OMARCITO007/plc-stm32/README.md

# plc-stm32
PLC básico basado en stm32 como controlador principal, con RS485, WIFI ESP32 y ETHERNET W5500

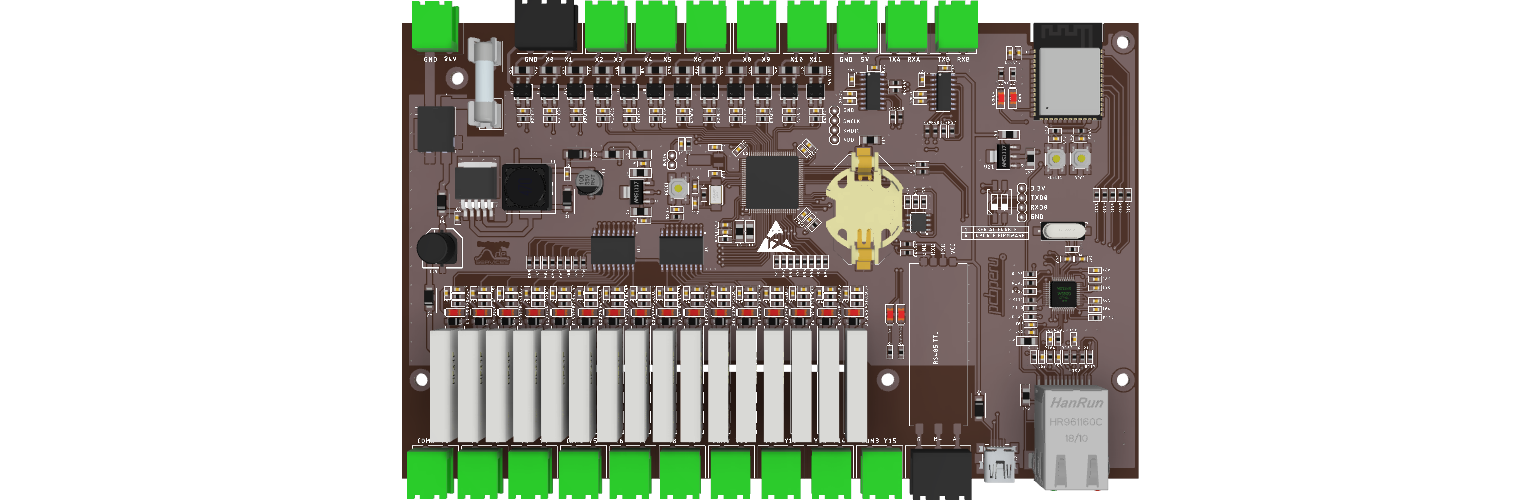
[picture p1: imagenes/PLC_YN_CPU v1.png]
Image text


## Microncontrolador
* ⚛️ STM32F407VGT6.
* 🍏 ESP32-WROOM-32U.

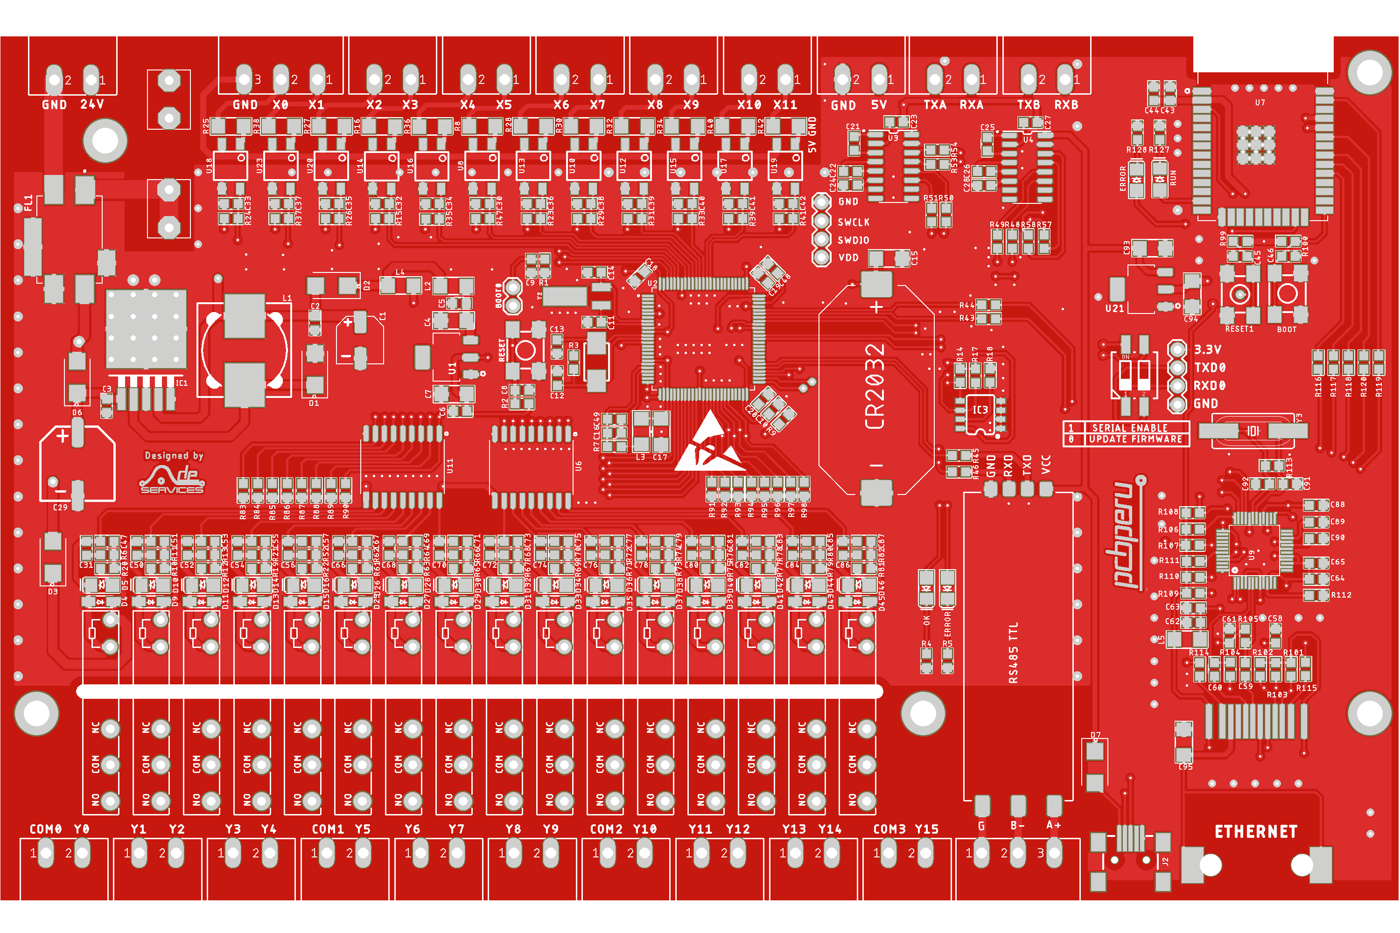
[picture p2: imagenes/PLC_YN_CPU.png]
Image text


## Voltaje de funcionamiento
* 🔌 24V.
* 🔌 Salida 5V.
## Caracteristicas
* 💙 x2 RS232.
* 💙 x1 RS485.
* 💙 x1 WIFI ESP32.
* 💙 x1 ETHERNET W5500.
* 💙 x1 EEPROM.
* 💙 x1 RTC.
* 💙 x1 USB para actualizar en modo BOOT y datos serial.
* ✔️ x12 entradas.
* ✔️ x16 salidas relé 2A.
