OMARCITO007/plc-stm32/imagenes/img.md

Imagen de la tarjeta pcb en 3D con los componentes
