OMARCITO007/plc-stm32/eagle-pcb/PLC_YN_CPU.brd

## EAGLE design eagle-pcb/PLC_YN_CPU.brd (2023-07-11)

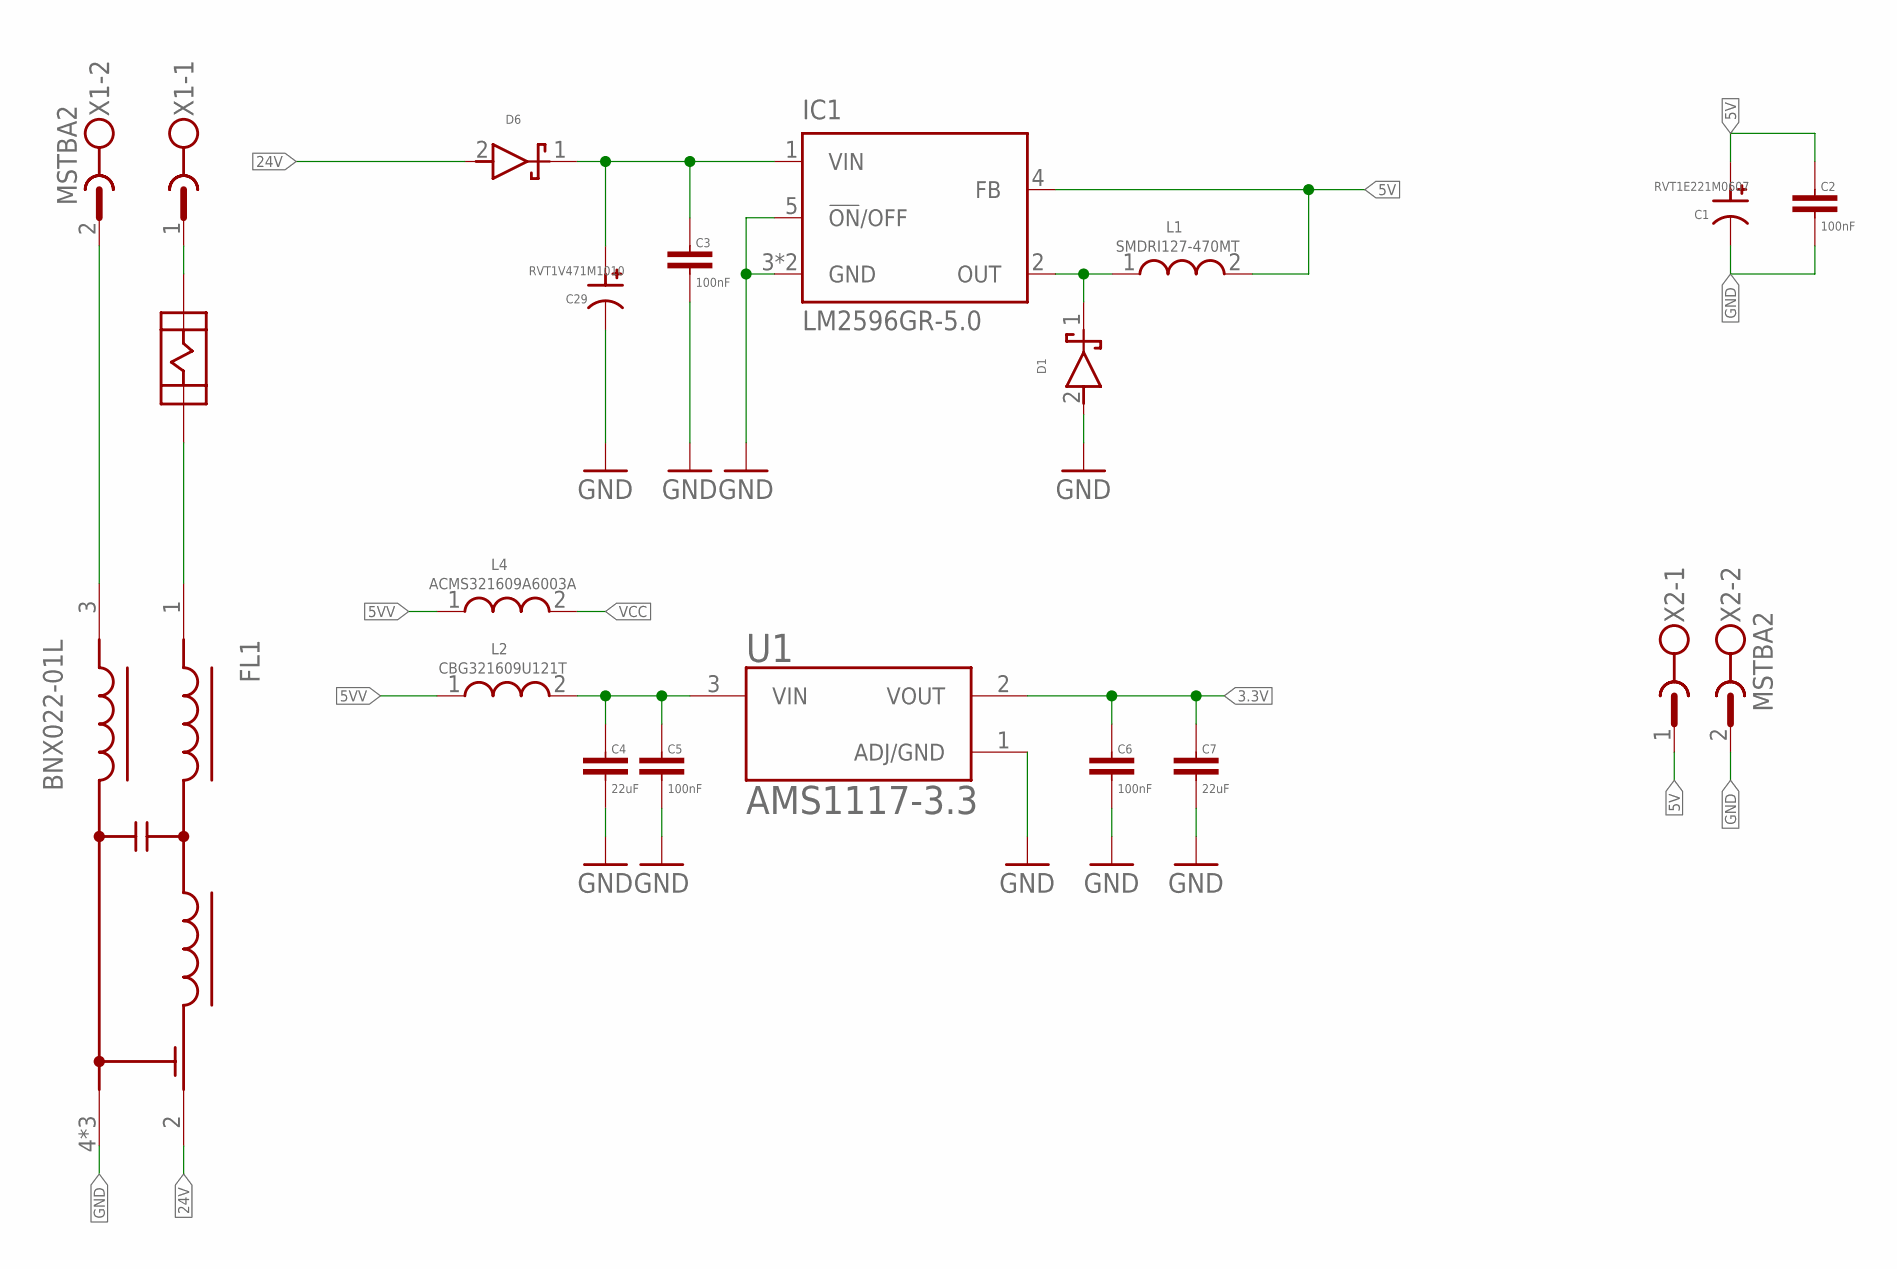
[picture p3: schematic PLC_YN_CPU.sch, sheet 1, ETAPA DE ALIMENTACIÓN]

Parts:
C1: RVT1E221M0607; CAP_100UF_6.3X7.7SMD
C2, C3, C5, C6: 100nF; C0603
C4, C7: 22uF; SMD_1206
C29: RVT1V471M1010; CAP_470UF_SMD_10X10.2
D1: SS36F; B360
D6: SS56; B360
F2: 3A; PORTAFUSIBLE
FL1: BNX022-01L; FIL_BNX022-01L
IC1: LM2596GR-5.0; TO263-5
L1: SMDRI127-470MT; IND
L2: CBG321609U121T; SMD_1206
L4: ACMS321609A6003A; SMD_1206
U1: AMS1117-3.3; SOT229P700X180-4N
X1, X2: MSTBA2

Connections:
3.3V: C6.1, C7.1, U1.2 (VOUT); also elsewhere on the board
5V: C1.P (1), C2.1, IC1.4 (FB), L1.2, X2.1; also elsewhere on the board
5VV: L2.1, L4.1; also elsewhere on the board
24V: D6.2, FL1.2 (CB); also elsewhere on the board
GND: C1.N (2), C2.2, C3.2, C4.2, C5.2, C6.2, C7.2, C29.N (2), D1.2, FL1.4 (CG), FL1.5 (CG), FL1.6 (CG), IC1.3 (GND), IC1.5 (!ON!/OFF), IC1.6 (GND), U1.1 (ADJ/GND), X2.2; also elsewhere on the board
unnamed: C4.1, C5.1, L2.2, U1.3 (VIN)
unnamed: C3.1, C29.P (1), D6.1, IC1.1 (VIN)
unnamed: D1.1, IC1.2 (OUT), L1.1
unnamed: F2.P$2, F2.P$4, X1.1
unnamed: FL1.3 (PSG), X1.2
unnamed: F2.P$1, F2.P$3, FL1.1 (B)
VCC: L4.2; also elsewhere on the board

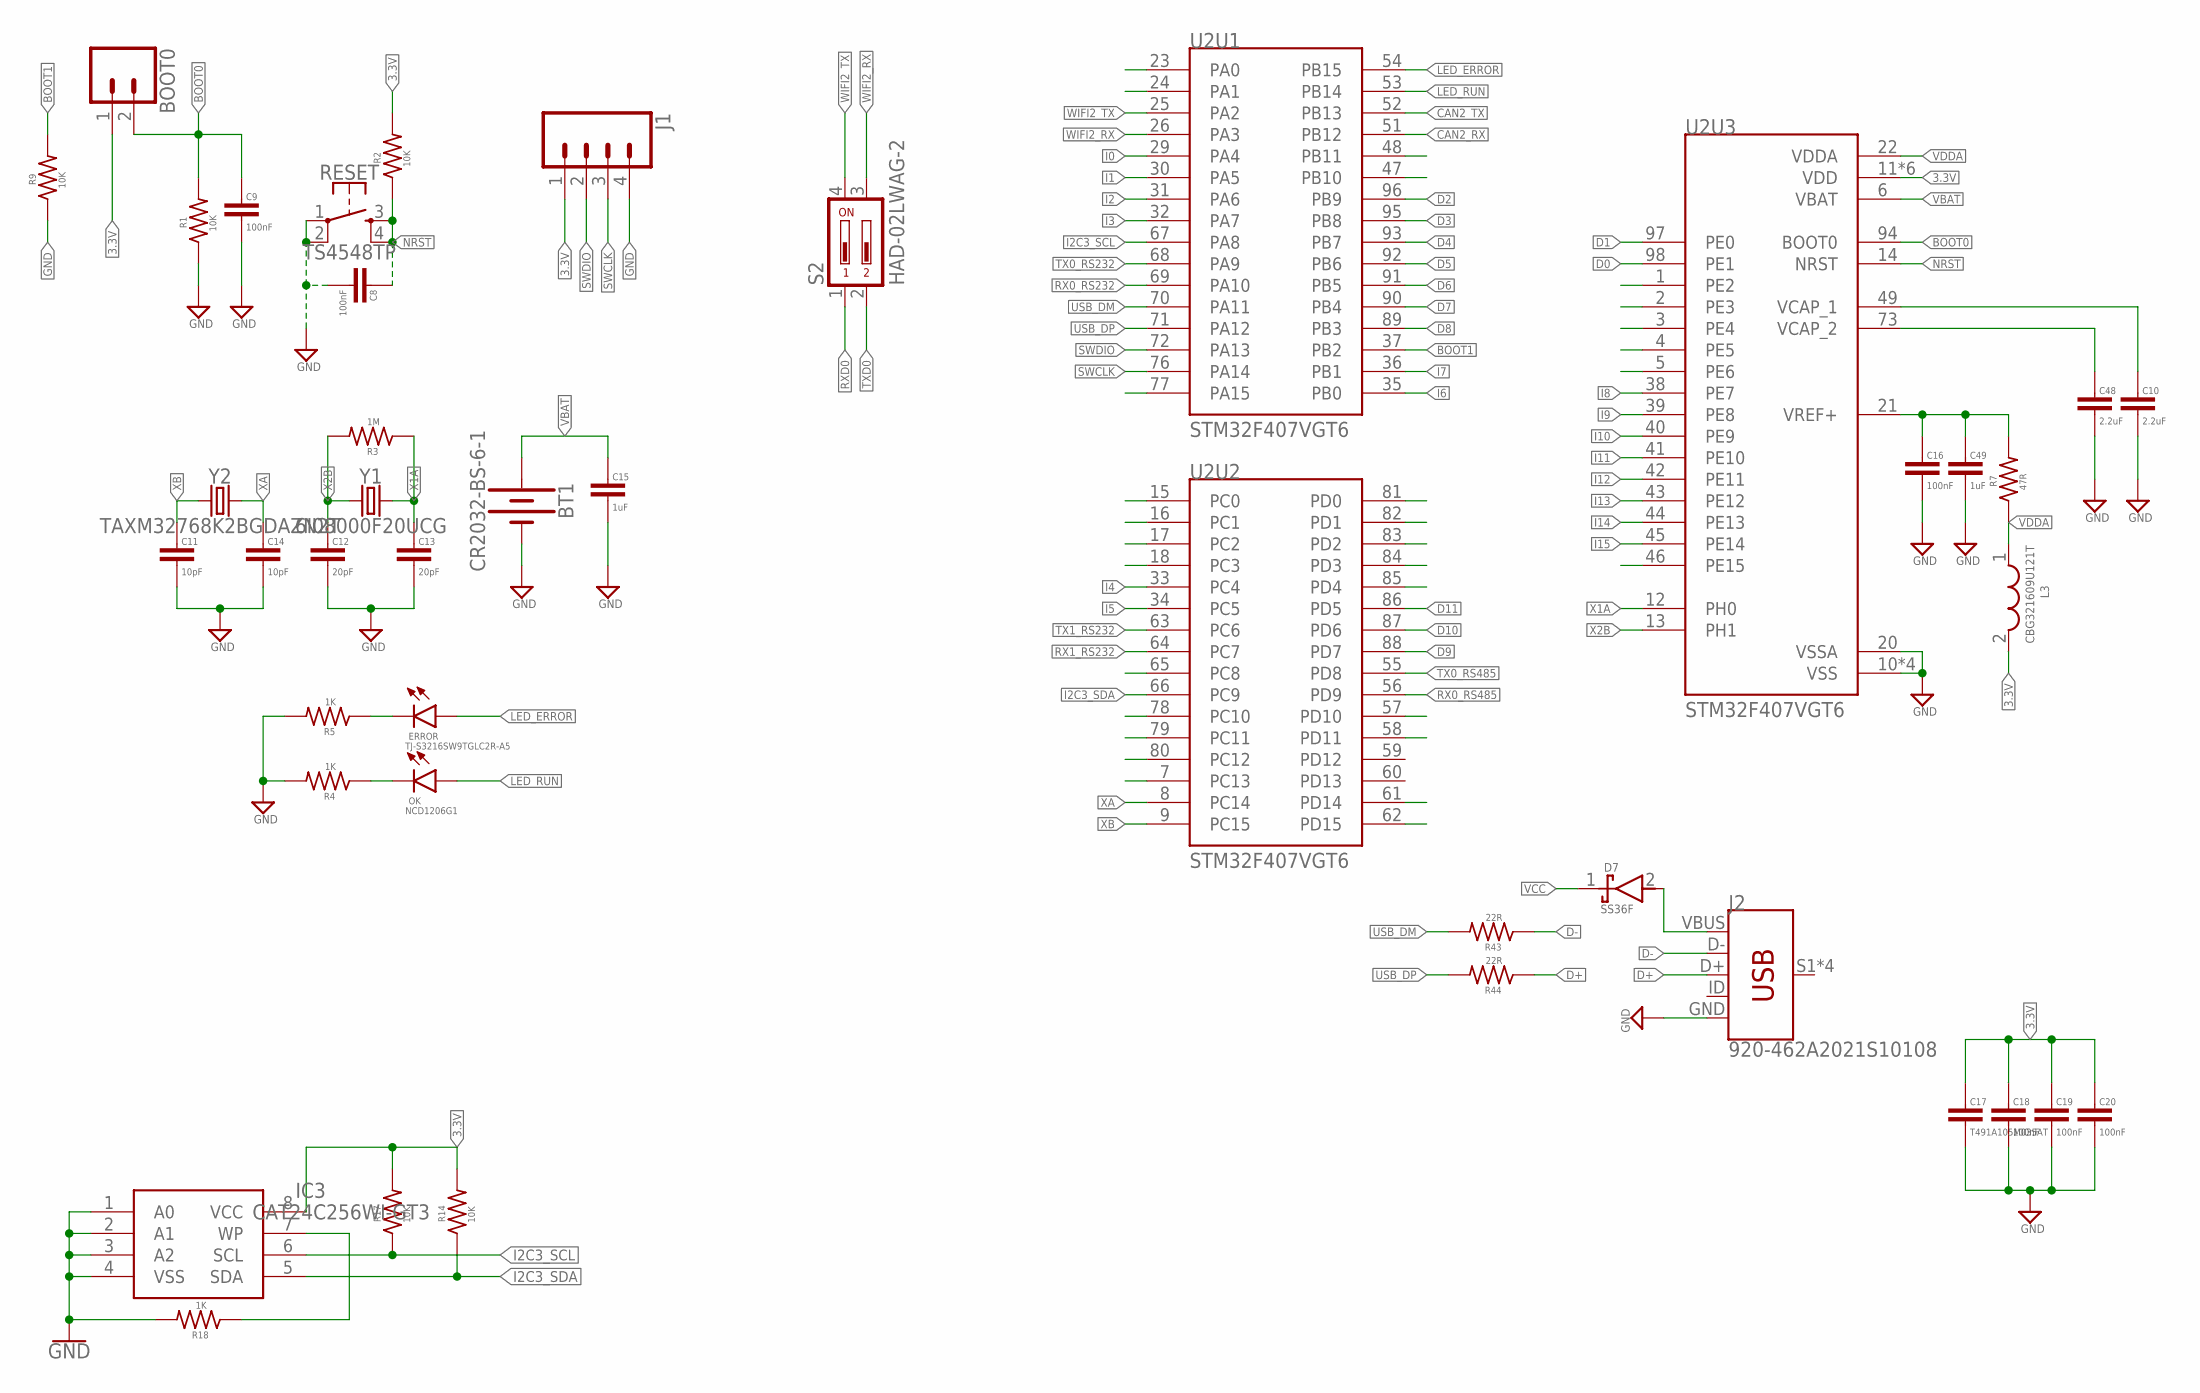
[picture p4: schematic PLC_YN_CPU.sch, sheet 2, MCU STM32F446]

Parts:
BOOT0: CONN_02; 1X02
BT1: CR2032-BS-6-1; BAT_CR2032_SMD
C8, C9, C16, C18, C19, C20: 100nF; C0603
C10, C48: 2.2uF; C0603
C11, C14: 10pF; C0603
C12, C13: 20pF; C0603
C15: 1uF; SMD_1206
C17: T491A105M035AT; SMD_1206
C49: 1uF; C0603
D7: SS36F; B360
ERROR: TJ-S3216SW9TGLC2R-A5; L1206
IC3: CAT24C256WI-GT3; SO08
J1: CONN_04; 1X04
J2: 920-462A2021S10108; USB-MINIB
L3: CBG321609U121T; SMD_1206
OK: NCD1206G1; L1206
R1, R2, R9, R14, R17: 10K; R0603
R3: 1M; R0603
R4, R5, R18: 1K; R0603
R7: 47R; R0603
R43, R44: 22R; R0603
RESET: TS4548TP; SWITCH
S2: HAD-02LWAG-2; CTS-219-02
U2: STM32F407VGT6; QFP50P1600X1600X160-100N
Y1: 6I08000F20UCG; CRYSTAL-SMD-5X3.2-2PAD
Y2: TAXM32768K2BGDAZN2T; CRYSTAL-SMD-2X6-CYL

Connections:
3.3V: BOOT0.1, C17.1, C18.1, C19.1, C20.1, IC3.8 (VCC), J1.1, L3.2, R2.2, R14.2, R17.2, U2.11 (VDD), U2.19 (VDD), U2.28 (VDD), U2.50 (VDD), U2.75 (VDD), U2.100 (VDD); also elsewhere on the board
BOOT0: BOOT0.2, C9.1, R1.2, U2.94 (BOOT0)
BOOT1: R9.2, U2.37 (PB2)
CAN2_RX: U2.51 (PB12)
CAN2_TX: U2.52 (PB13)
D0: U2.98 (PE1); also elsewhere on the board
D1: U2.97 (PE0); also elsewhere on the board
D2: U2.96 (PB9); also elsewhere on the board
D3: U2.95 (PB8); also elsewhere on the board
D4: U2.93 (PB7); also elsewhere on the board
D5: U2.92 (PB6); also elsewhere on the board
D6: U2.91 (PB5); also elsewhere on the board
D7: U2.90 (PB4); also elsewhere on the board
D8: U2.89 (PB3); also elsewhere on the board
D9: U2.88 (PD7); also elsewhere on the board
D10: U2.87 (PD6); also elsewhere on the board
D11: U2.86 (PD5); also elsewhere on the board
D+: J2.D+, R44.1
D-: J2.D-, R43.1
GND: BT1.N (-), C8.2, C9.2, C10.2, C11.2, C12.2, C13.2, C14.2, C15.2, C16.2, C17.2, C18.2, C19.2, C20.2, C48.2, C49.2, IC3.1 (A0), IC3.2 (A1), IC3.3 (A2), IC3.4 (VSS), J1.4, J2.GND, R1.1, R4.2, R5.2, R9.1, R18.2, RESET.1, RESET.2, U2.10 (VSS), U2.20 (VSSA), U2.27 (VSS), U2.74 (VSS), U2.99 (VSS); also elsewhere on the board
I0: U2.29 (PA4); also elsewhere on the board
I1: U2.30 (PA5); also elsewhere on the board
I2: U2.31 (PA6); also elsewhere on the board
I2C3_SCL: IC3.6 (SCL), R17.1, U2.67 (PA8)
I2C3_SDA: IC3.5 (SDA), R14.1, U2.66 (PC9)
I3: U2.32 (PA7); also elsewhere on the board
I4: U2.33 (PC4); also elsewhere on the board
I5: U2.34 (PC5); also elsewhere on the board
I6: U2.35 (PB0); also elsewhere on the board
I7: U2.36 (PB1); also elsewhere on the board
I8: U2.38 (PE7); also elsewhere on the board
I9: U2.39 (PE8); also elsewhere on the board
I10: U2.40 (PE9); also elsewhere on the board
I11: U2.41 (PE10); also elsewhere on the board
I12: U2.42 (PE11); also elsewhere on the board
I13: U2.43 (PE12); also elsewhere on the board
I14: U2.44 (PE13); also elsewhere on the board
I15: U2.45 (PE14); also elsewhere on the board
LED_ERROR: ERROR.A, U2.54 (PB15)
LED_RUN: OK.A, U2.53 (PB14)
unnamed: C10.1, U2.49 (VCAP_1)
unnamed: C48.1, U2.73 (VCAP_2)
unnamed: C16.1, C49.1, R7.2, U2.21 (VREF+)
unnamed: D7.2, J2.VBUS
unnamed: IC3.7 (WP), R18.1
unnamed: ERROR.C, R5.1
unnamed: OK.C, R4.1
NRST: C8.1, R2.1, RESET.3, RESET.4, U2.14 (NRST)
RX0_RS232: U2.69 (PA10); also elsewhere on the board
RX0_RS485: U2.56 (PD9); also elsewhere on the board
RX1_RS232: U2.64 (PC7); also elsewhere on the board
RXD0: S2.1; also elsewhere on the board
SWCLK: J1.3, U2.76 (PA14)
SWDIO: J1.2, U2.72 (PA13)
TX0_RS232: U2.68 (PA9); also elsewhere on the board
TX0_RS485: U2.55 (PD8); also elsewhere on the board
TX1_RS232: U2.63 (PC6); also elsewhere on the board
TXD0: S2.2; also elsewhere on the board
USB_DM: R43.2, U2.70 (PA11)
USB_DP: R44.2, U2.71 (PA12)
VBAT: BT1.P (+), C15.1, U2.6 (VBAT)
VCC: D7.1; also elsewhere on the board
VDDA: L3.1, R7.1, U2.22 (VDDA)
WIFI2_RX: S2.3, U2.26 (PA3)
WIFI2_TX: S2.4, U2.25 (PA2)
X1A: C13.1, R3.1, U2.12 (PH0), Y1.P$2 (2)
X2B: C12.1, R3.2, U2.13 (PH1), Y1.P$1 (1)
XA: C14.1, U2.8 (PC14), Y2.X2 (2)
XB: C11.1, U2.9 (PC15), Y2.X1 (1)

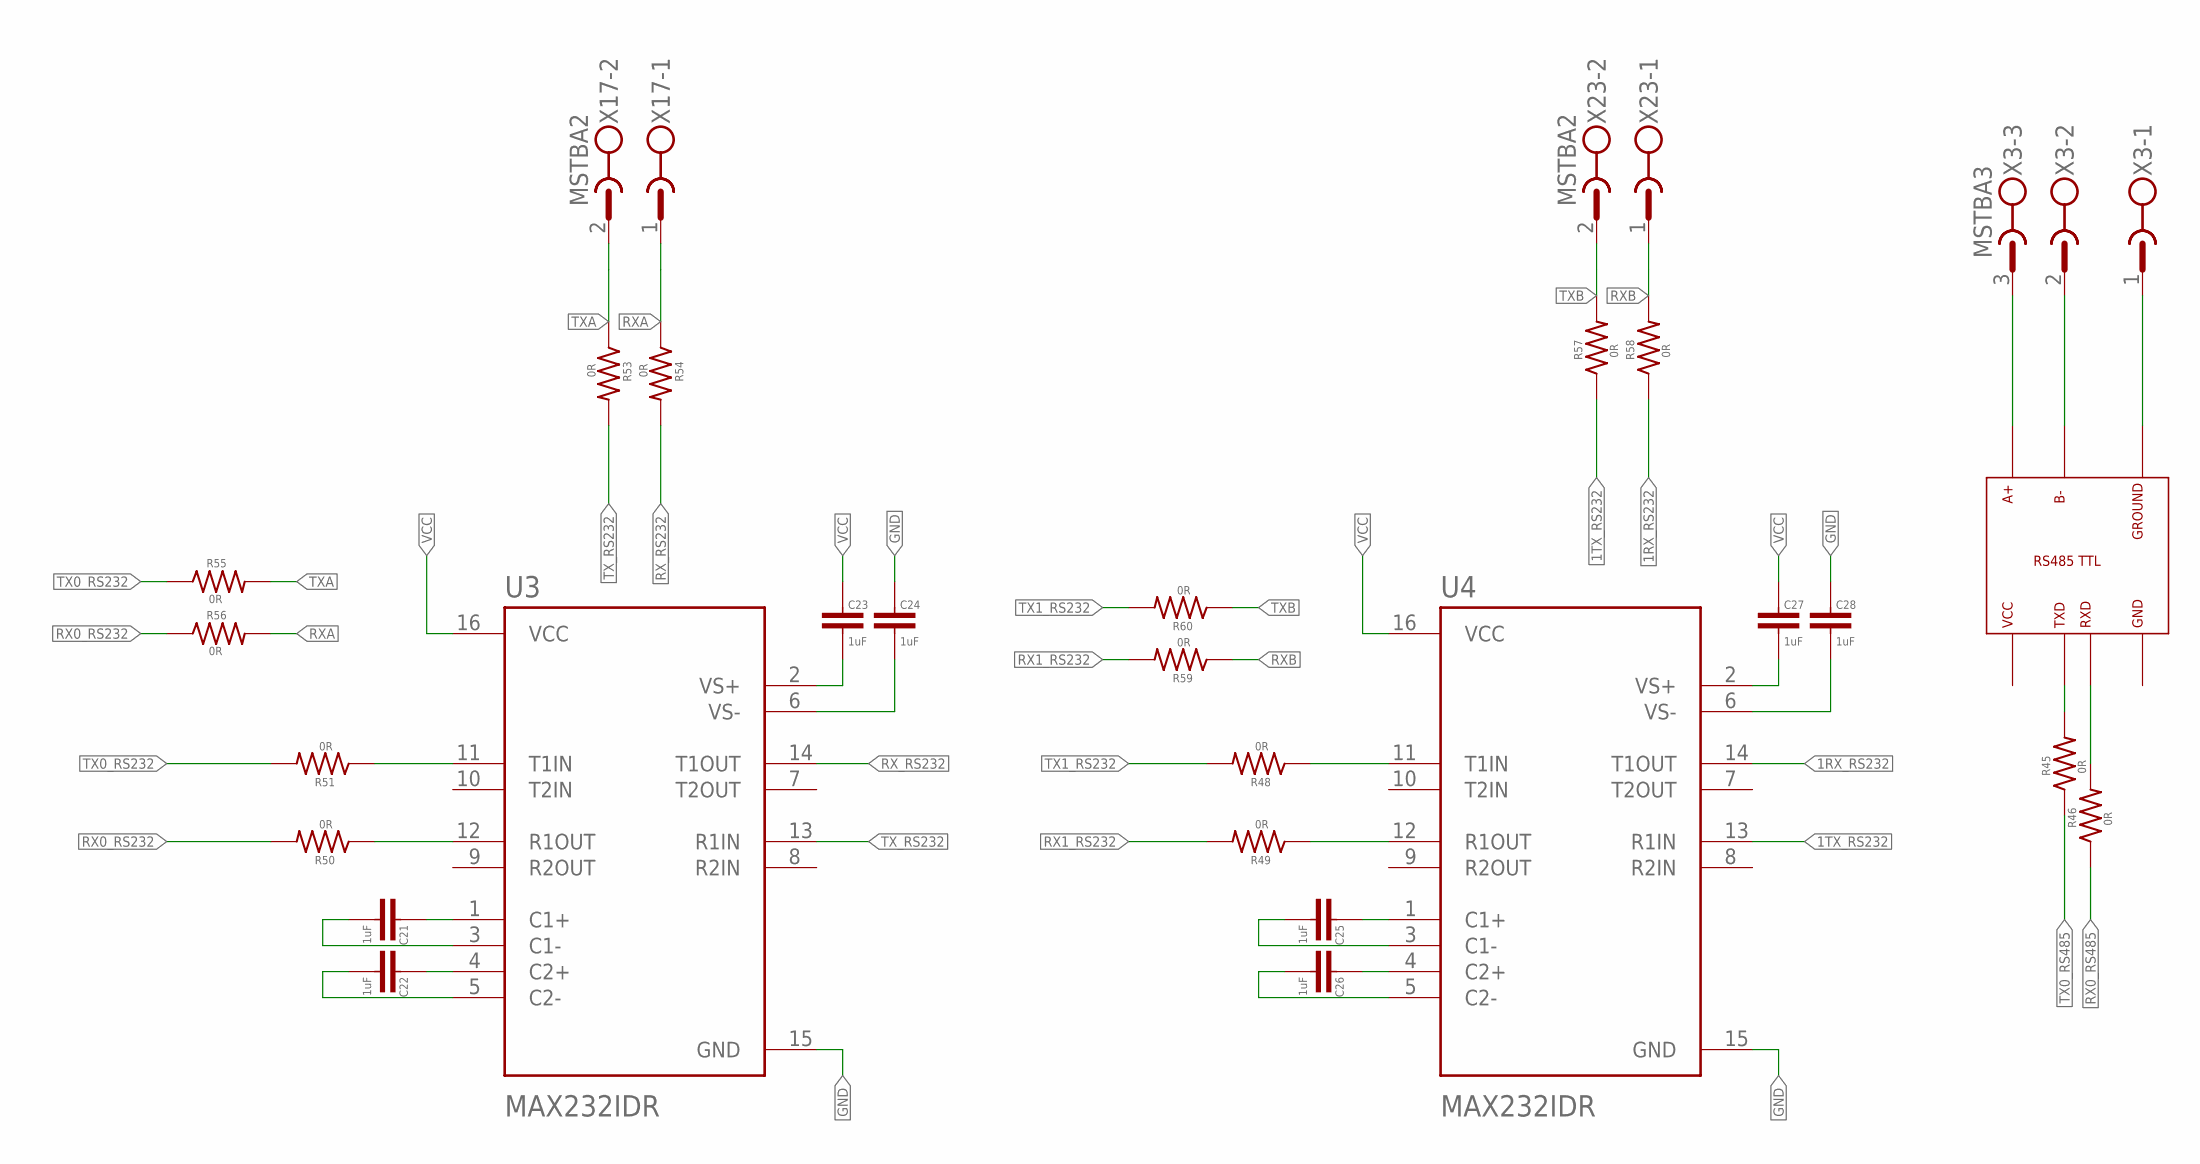
[picture p5: schematic PLC_YN_CPU.sch, sheet 3, COMUNICACION]

Parts:
C21, C22, C23, C24, C25, C26, C27, C28: 1uF; C0603
R45, R46, R48, R49, R50, R51, R53, R54, R55, R56, R57, R58, R59, R60: 0R; R0603
U3, U4: MAX232IDR; SOIC127P600X175-16N
U5: RS485; RS485TTL
X3: MSTBA3
X17, X23: MSTBA2

Connections:
1RX_RS232: R58.1, U4.14 (T1OUT)
1TX_RS232: R57.1, U4.13 (R1IN)
GND: C24.1, C28.1, U3.15 (GND), U4.15 (GND), U5.GND; also elsewhere on the board
unnamed: U5.A+, X3.3
unnamed: R45.2, U5.TXD
unnamed: U5.B-, X3.2
unnamed: U5.GROUND, X3.1
unnamed: C21.1, U3.1 (C1+)
unnamed: C21.2, U3.3 (C1-)
unnamed: C22.1, U3.4 (C2+)
unnamed: C22.2, U3.5 (C2-)
unnamed: C25.1, U4.1 (C1+)
unnamed: C23.2, U3.2 (VS+)
unnamed: C24.2, U3.6 (VS-)
unnamed: C25.2, U4.3 (C1-)
unnamed: C26.1, U4.4 (C2+)
unnamed: C26.2, U4.5 (C2-)
unnamed: C27.2, U4.2 (VS+)
unnamed: C28.2, U4.6 (VS-)
unnamed: R46.2, U5.RXD
unnamed: R48.1, U4.11 (T1IN)
unnamed: R49.1, U4.12 (R1OUT)
unnamed: R50.1, U3.12 (R1OUT)
unnamed: R51.1, U3.11 (T1IN)
RX0_RS232: R50.2, R56.1; also elsewhere on the board
RX0_RS485: R46.1; also elsewhere on the board
RX1_RS232: R49.2, R59.2; also elsewhere on the board
RXA: R54.1, R56.2, X17.1
RXB: R58.2, R59.1, X23.1
RX_RS232: R54.2, U3.14 (T1OUT)
TX0_RS232: R51.2, R55.1; also elsewhere on the board
TX0_RS485: R45.1; also elsewhere on the board
TX1_RS232: R48.2, R60.2; also elsewhere on the board
TXA: R53.1, R55.2, X17.2
TXB: R57.2, R60.1, X23.2
TX_RS232: R53.2, U3.13 (R1IN)
VCC: C23.1, C27.1, U3.16 (VCC), U4.16 (VCC), U5.VCC; also elsewhere on the board

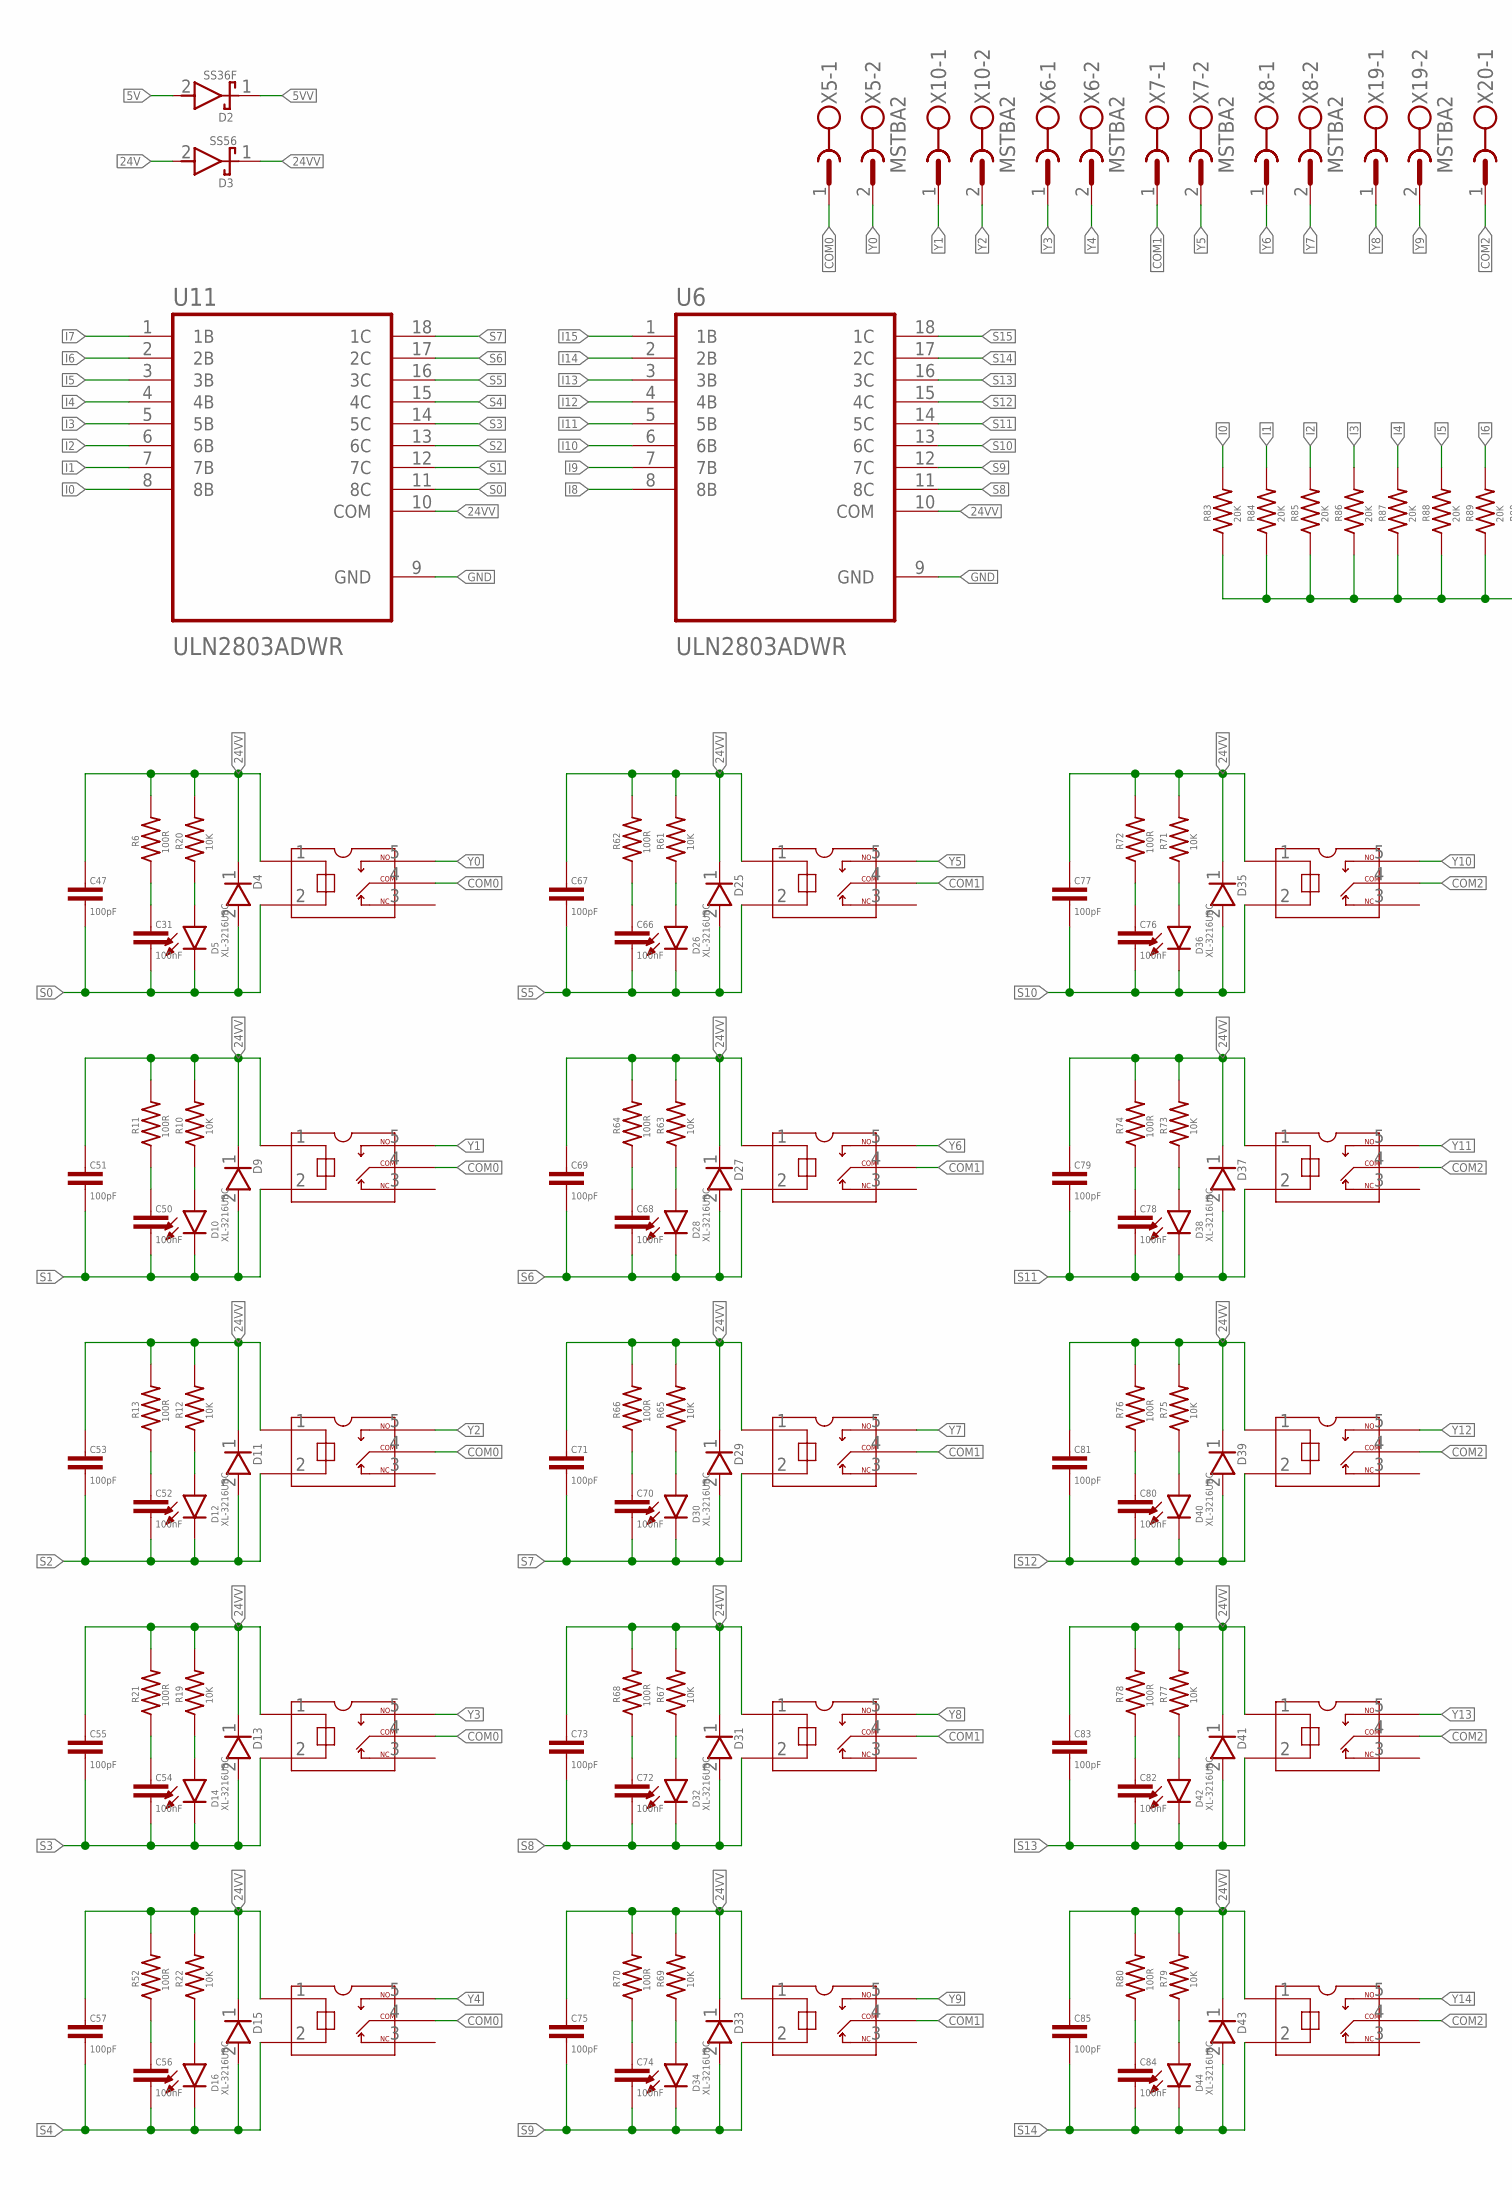
[picture p6: schematic PLC_YN_CPU.sch, sheet 4, OUTPUT, part in row 1, column 1]

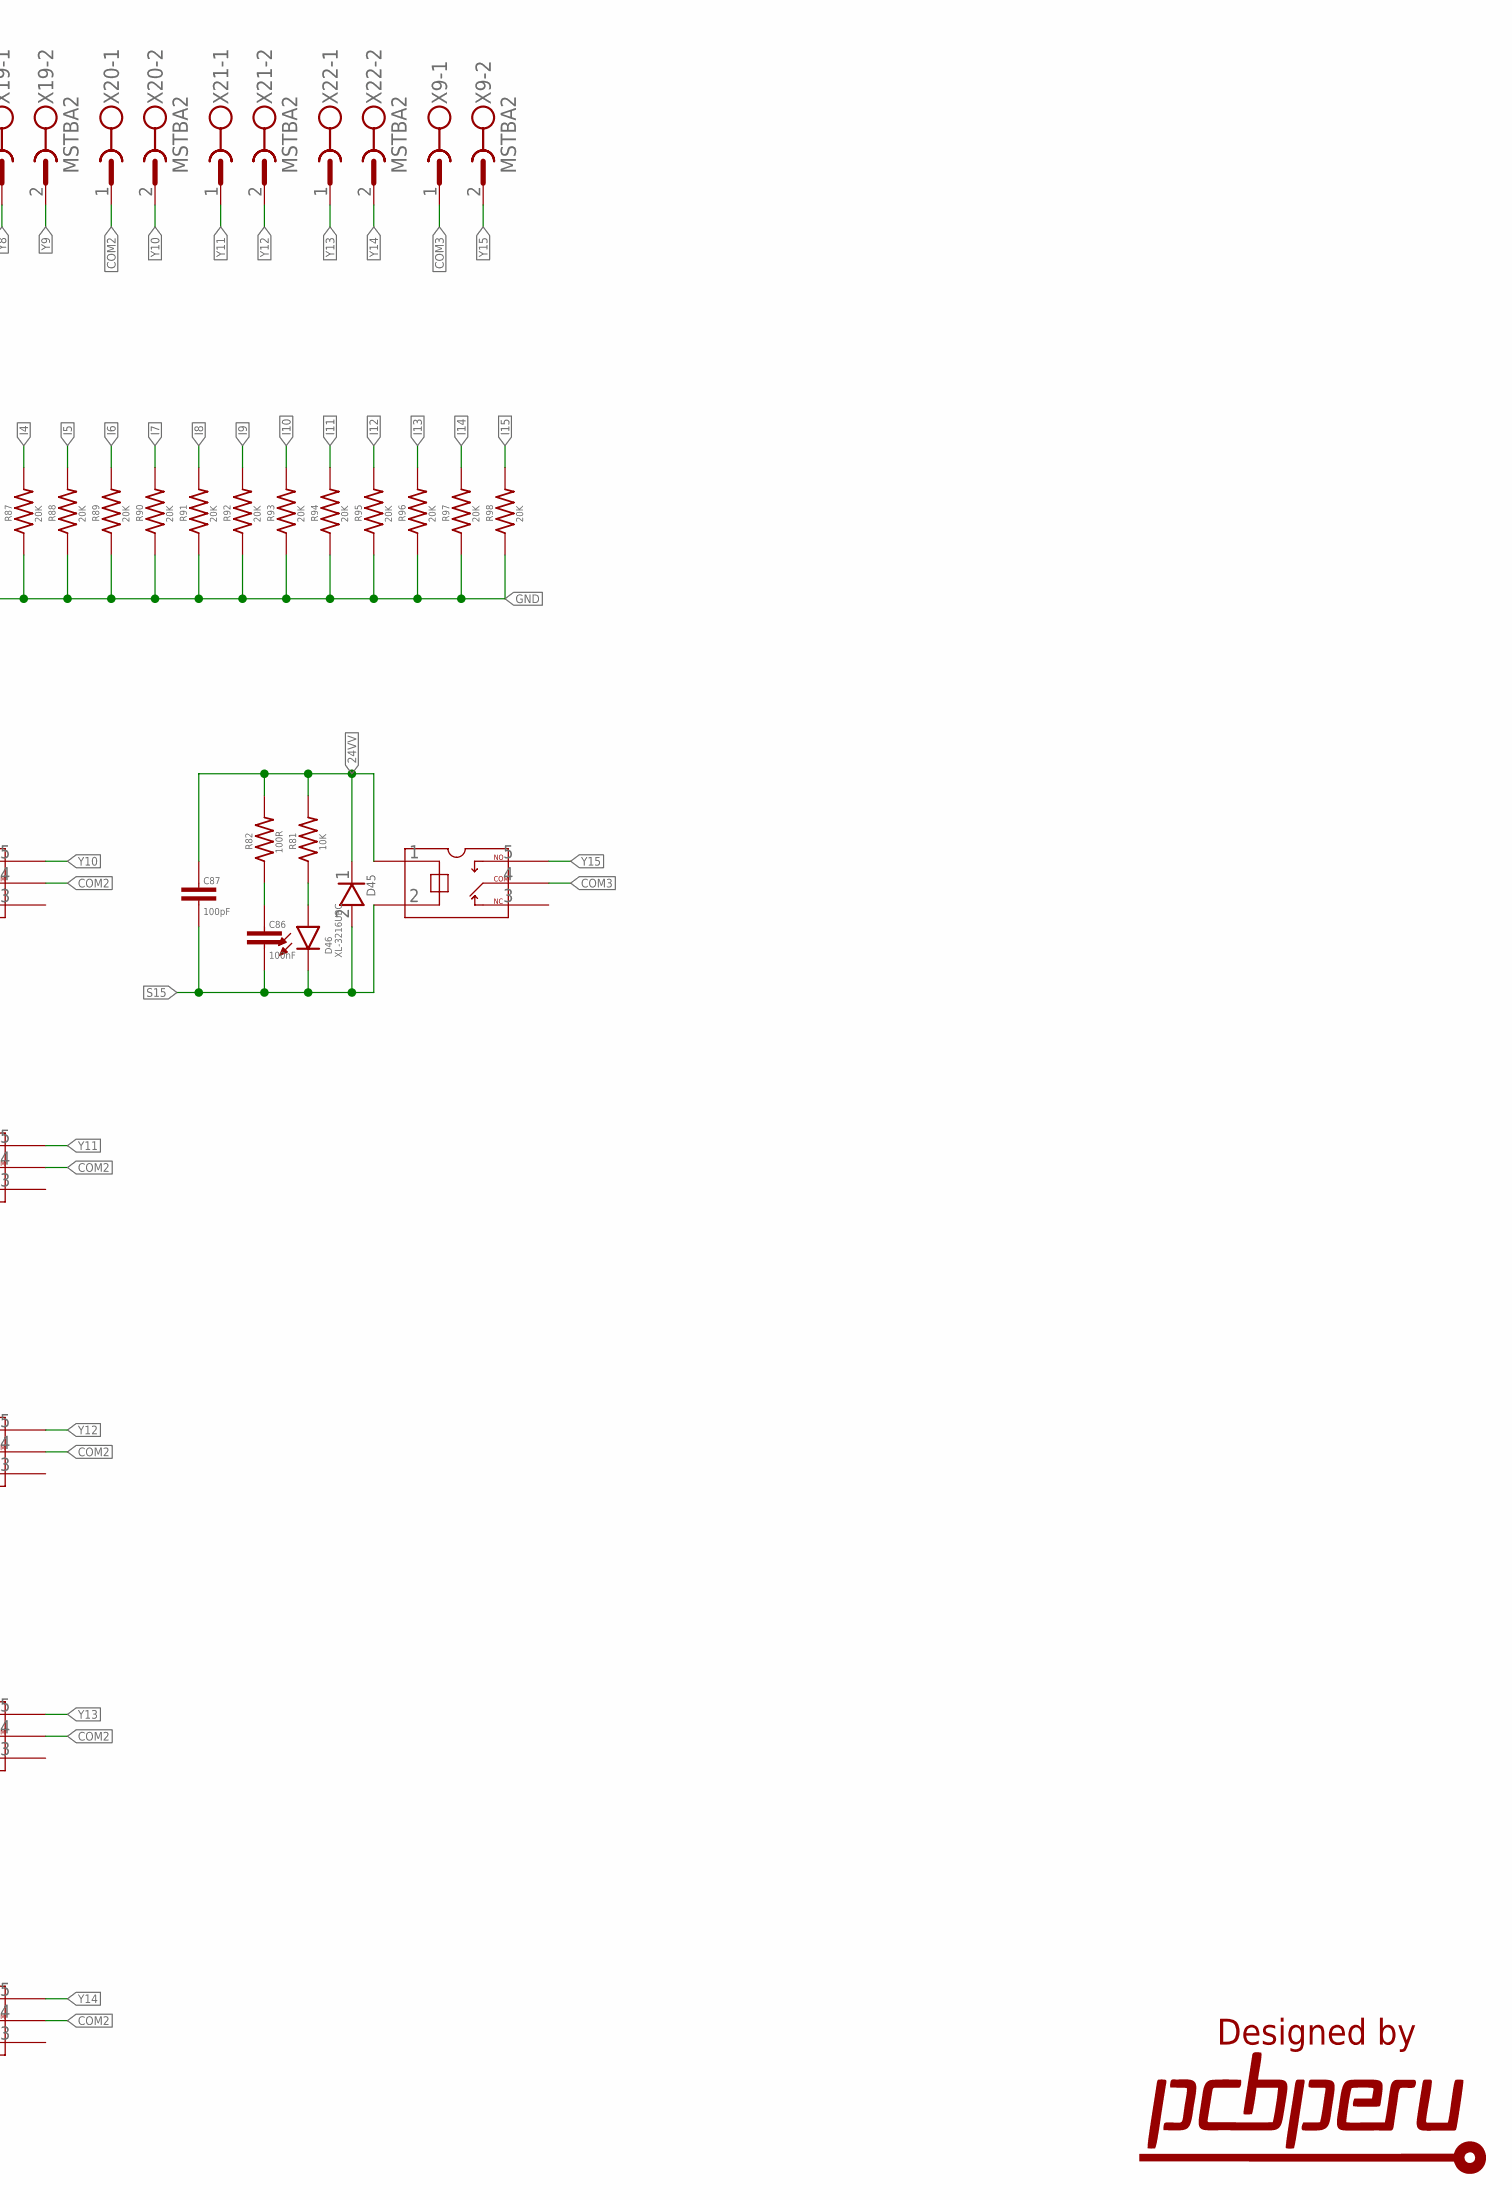
[picture p7: schematic PLC_YN_CPU.sch, sheet 4, OUTPUT, part in row 1, column 2]

Parts:
C31, C50, C52, C54, C56, C66, C68, C70, C72, C74, C76, C78, C80, C82, C84, C86: 100nF; C0603
C47, C51, C53, C55, C57, C67, C69, C71, C73, C75, C77, C79, C81, C83, C85, C87: 100pF; C0603
D2: SS36F; B360
D3: SS56; B360
D4, D9, D11, D13, D15, D25, D27, D29, D31, D33, D35, D37, D39, D41, D43, D45: 1N4148W-13-F; SOD3716X145N
D5, D10, D12, D14, D16, D26, D28, D30, D32, D34, D36, D38, D40, D42, D44, D46: XL-3216UBC; L1206
R6, R11, R13, R21, R52, R62, R64, R66, R68, R70, R72, R74, R76, R78, R80, R82: 100R; R0603
R10, R12, R19, R20, R22, R61, R63, R65, R67, R69, R71, R73, R75, R77, R79, R81: 10K; R0603
R83, R84, R85, R86, R87, R88, R89, R90, R91, R92, R93, R94, R95, R96, R97, R98: 20K; R0603
RL1, RL3, RL4, RL5, RL6, RL11, RL12, RL13, RL14, RL15, RL16, RL17, RL18, RL19, RL20, RL21: HF41F
U6, U11: ULN2803ADWR; SOIC127P1030X265-18N
X5, X6, X7, X8, X9, X10, X19, X20, X21, X22: MSTBA2

Connections:
5V: D2.2; also elsewhere on the board
5VV: D2.1; also elsewhere on the board
24V: D3.2; also elsewhere on the board
24VV: C47.1, C51.1, C53.1, C55.1, C57.1, C67.1, C69.1, C71.1, C73.1, C75.1, C77.1, C79.1, C81.1, C83.1, C85.1, C87.1, D3.1, D4.1 (K), D9.1 (K), D11.1 (K), D13.1 (K), D15.1 (K), D25.1 (K), D27.1 (K), D29.1 (K), D31.1 (K), D33.1 (K), D35.1 (K), D37.1 (K), D39.1 (K), D41.1 (K), D43.1 (K), D45.1 (K), R6.2, R10.2, R11.2, R12.2, R13.2, R19.2, R20.2, R21.2, R22.2, R52.2, R61.2, R62.2, R63.2, R64.2, R65.2, R66.2, R67.2, R68.2, R69.2, R70.2, R71.2, R72.2, R73.2, R74.2, R75.2, R76.2, R77.2, R78.2, R79.2, R80.2, R81.2, R82.2, RL1.1, RL3.1, RL4.1, RL5.1, RL6.1, RL11.1, RL12.1, RL13.1, RL14.1, RL15.1, RL16.1, RL17.1, RL18.1, RL19.1, RL20.1, RL21.1, U6.10 (COM), U11.10 (COM)
COM0: RL1.4, RL3.4, RL4.4, RL5.4, RL6.4, X5.1
COM1: RL11.4, RL12.4, RL13.4, RL14.4, RL15.4, X7.1
COM2: RL16.4, RL17.4, RL18.4, RL19.4, RL20.4, X20.1
COM3: RL21.4, X9.1
GND: R83.1, R84.1, R85.1, R86.1, R87.1, R88.1, R89.1, R90.1, R91.1, R92.1, R93.1, R94.1, R95.1, R96.1, R97.1, R98.1, U6.9 (GND), U11.9 (GND); also elsewhere on the board
I0: R83.2, U11.8 (8B); also elsewhere on the board
I1: R84.2, U11.7 (7B); also elsewhere on the board
I2: R85.2, U11.6 (6B); also elsewhere on the board
I3: R86.2, U11.5 (5B); also elsewhere on the board
I4: R87.2, U11.4 (4B); also elsewhere on the board
I5: R88.2, U11.3 (3B); also elsewhere on the board
I6: R89.2, U11.2 (2B); also elsewhere on the board
I7: R90.2, U11.1 (1B); also elsewhere on the board
I8: R91.2, U6.8 (8B); also elsewhere on the board
I9: R92.2, U6.7 (7B); also elsewhere on the board
I10: R93.2, U6.6 (6B); also elsewhere on the board
I11: R94.2, U6.5 (5B); also elsewhere on the board
I12: R95.2, U6.4 (4B); also elsewhere on the board
I13: R96.2, U6.3 (3B); also elsewhere on the board
I14: R97.2, U6.2 (2B); also elsewhere on the board
I15: R98.2, U6.1 (1B); also elsewhere on the board
unnamed: C31.1, R6.1
unnamed: D10.A, R10.1
unnamed: D5.A, R20.1
unnamed: C50.1, R11.1
unnamed: D12.A, R12.1
unnamed: C52.1, R13.1
unnamed: D14.A, R19.1
unnamed: C54.1, R21.1
unnamed: D16.A, R22.1
unnamed: C56.1, R52.1
unnamed: D26.A, R61.1
unnamed: C66.1, R62.1
unnamed: D28.A, R63.1
unnamed: C68.1, R64.1
unnamed: D30.A, R65.1
unnamed: C70.1, R66.1
unnamed: D32.A, R67.1
unnamed: C72.1, R68.1
unnamed: D34.A, R69.1
unnamed: C74.1, R70.1
unnamed: D36.A, R71.1
unnamed: C76.1, R72.1
unnamed: D38.A, R73.1
unnamed: C78.1, R74.1
unnamed: D40.A, R75.1
unnamed: C80.1, R76.1
unnamed: D42.A, R77.1
unnamed: C82.1, R78.1
unnamed: D44.A, R79.1
unnamed: C84.1, R80.1
unnamed: D46.A, R81.1
unnamed: C86.1, R82.1
S0: C31.2, C47.2, D4.2 (A), D5.C, RL1.2, U11.11 (8C)
S1: C50.2, C51.2, D9.2 (A), D10.C, RL3.2, U11.12 (7C)
S2: C52.2, C53.2, D11.2 (A), D12.C, RL4.2, U11.13 (6C)
S3: C54.2, C55.2, D13.2 (A), D14.C, RL5.2, U11.14 (5C)
S4: C56.2, C57.2, D15.2 (A), D16.C, RL6.2, U11.15 (4C)
S5: C66.2, C67.2, D25.2 (A), D26.C, RL11.2, U11.16 (3C)
S6: C68.2, C69.2, D27.2 (A), D28.C, RL12.2, U11.17 (2C)
S7: C70.2, C71.2, D29.2 (A), D30.C, RL13.2, U11.18 (1C)
S8: C72.2, C73.2, D31.2 (A), D32.C, RL14.2, U6.11 (8C)
S9: C74.2, C75.2, D33.2 (A), D34.C, RL15.2, U6.12 (7C)
S10: C76.2, C77.2, D35.2 (A), D36.C, RL16.2, U6.13 (6C)
S11: C78.2, C79.2, D37.2 (A), D38.C, RL17.2, U6.14 (5C)
S12: C80.2, C81.2, D39.2 (A), D40.C, RL18.2, U6.15 (4C)
S13: C82.2, C83.2, D41.2 (A), D42.C, RL19.2, U6.16 (3C)
S14: C84.2, C85.2, D43.2 (A), D44.C, RL20.2, U6.17 (2C)
S15: C86.2, C87.2, D45.2 (A), D46.C, RL21.2, U6.18 (1C)
Y0: RL1.5, X5.2
Y1: RL3.5, X10.1
Y2: RL4.5, X10.2
Y3: RL5.5, X6.1
Y4: RL6.5, X6.2
Y5: RL11.5, X7.2
Y6: RL12.5, X8.1
Y7: RL13.5, X8.2
Y8: RL14.5, X19.1
Y9: RL15.5, X19.2
Y10: RL16.5, X20.2
Y11: RL17.5, X21.1
Y12: RL18.5, X21.2
Y13: RL19.5, X22.1
Y14: RL20.5, X22.2
Y15: RL21.5, X9.2
