OMARCITO007/plc-stm32/eagle-pcb/PLC_YN_CPU.brd

## EAGLE design eagle-pcb/PLC_YN_CPU.brd (continued)

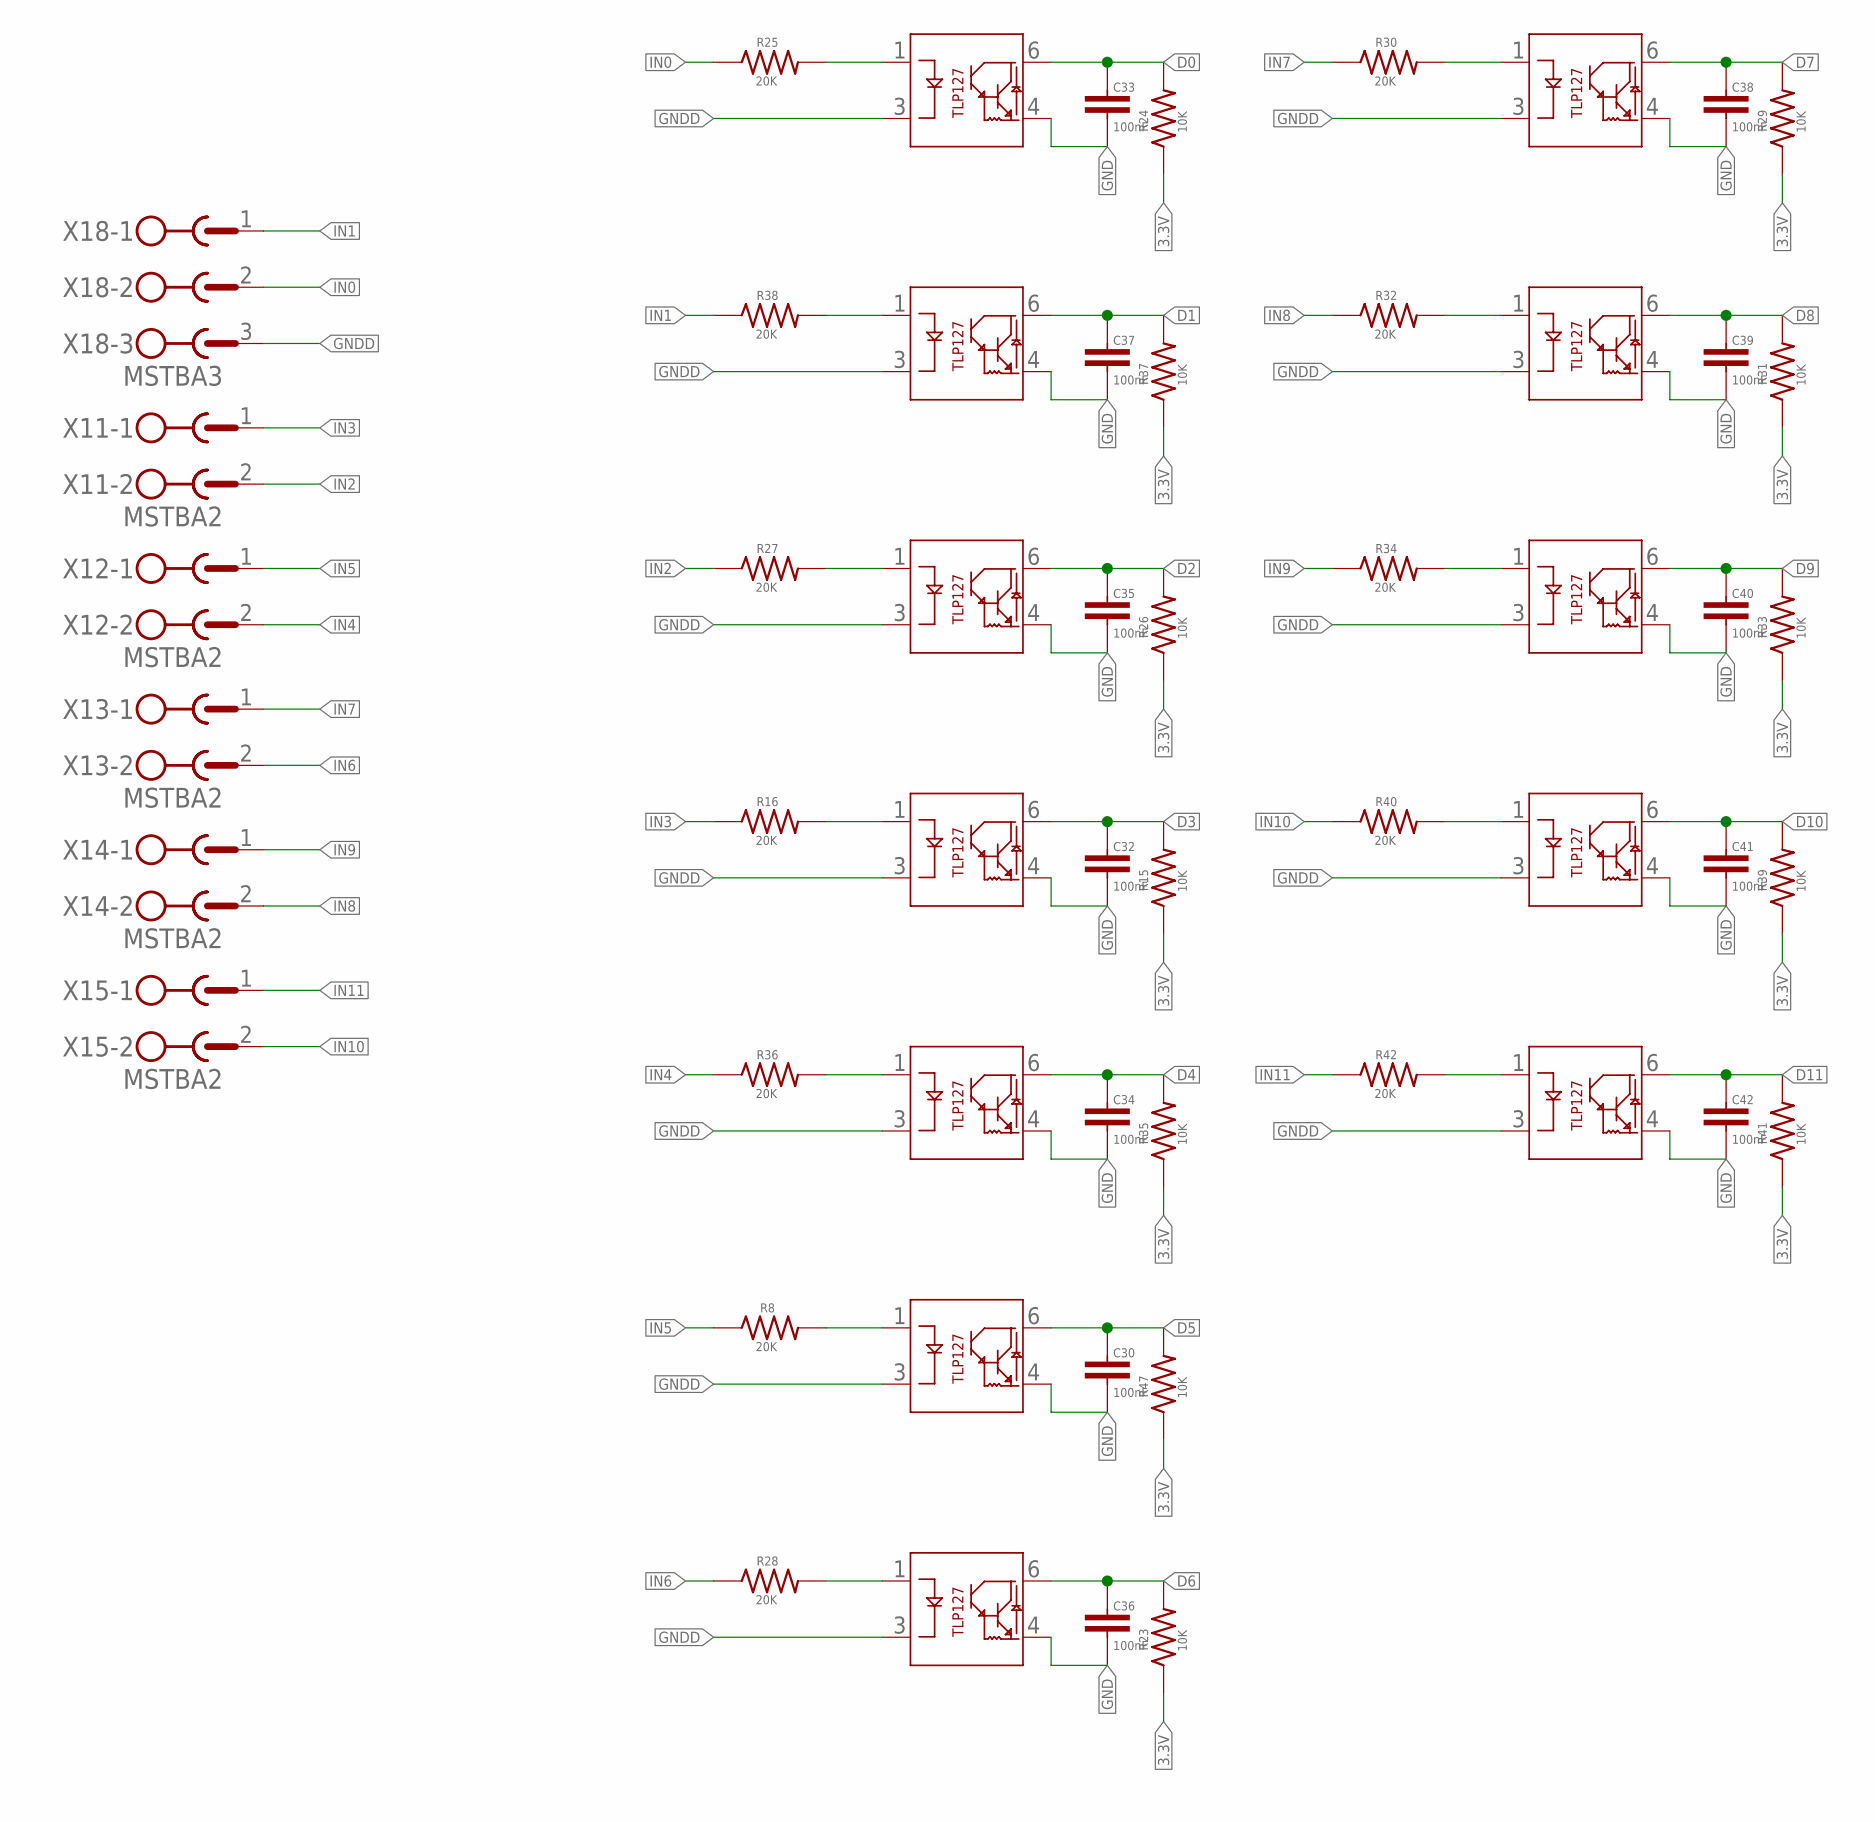
[picture p8: schematic PLC_YN_CPU.sch, sheet 5, INPUT]

Parts:
C30, C32, C33, C34, C35, C36, C37, C38, C39, C40, C41, C42: 100nF; C0603
R8, R16, R25, R27, R28, R30, R32, R34, R36, R38, R40, R42: 20K; SMD_1206
R15, R23, R24, R26, R29, R31, R33, R35, R37, R39, R41, R47: 10K; R0603
U8, U10, U12, U13, U14, U15, U16, U17, U18, U19, U20, U23: LTV-357T-B-IN; TLP127
X11, X12, X13, X14, X15: MSTBA2
X18: MSTBA3

Connections:
3.3V: R15.1, R23.1, R24.1, R26.1, R29.1, R31.1, R33.1, R35.1, R37.1, R39.1, R41.1, R47.1; also elsewhere on the board
D0: C33.1, R24.2, U18.6; also elsewhere on the board
D1: C37.1, R37.2, U23.6; also elsewhere on the board
D2: C35.1, R26.2, U20.6; also elsewhere on the board
D3: C32.1, R15.2, U14.6; also elsewhere on the board
D4: C34.1, R35.2, U16.6; also elsewhere on the board
D5: C30.1, R47.2, U8.6; also elsewhere on the board
D6: C36.1, R23.2, U13.6; also elsewhere on the board
D7: C38.1, R29.2, U10.6; also elsewhere on the board
D8: C39.1, R31.2, U12.6; also elsewhere on the board
D9: C40.1, R33.2, U15.6; also elsewhere on the board
D10: C41.1, R39.2, U17.6; also elsewhere on the board
D11: C42.1, R41.2, U19.6; also elsewhere on the board
GND: C30.2, C32.2, C33.2, C34.2, C35.2, C36.2, C37.2, C38.2, C39.2, C40.2, C41.2, C42.2, U8.4, U10.4, U12.4, U13.4, U14.4, U15.4, U16.4, U17.4, U18.4, U19.4, U20.4, U23.4; also elsewhere on the board
GNDD: U8.3, U10.3, U12.3, U13.3, U14.3, U15.3, U16.3, U17.3, U18.3, U19.3, U20.3, U23.3, X18.3
IN0: R25.1, X18.2
IN1: R38.1, X18.1
IN2: R27.1, X11.2
IN3: R16.1, X11.1
IN4: R36.1, X12.2
IN5: R8.1, X12.1
IN6: R28.1, X13.2
IN7: R30.1, X13.1
IN8: R32.1, X14.2
IN9: R34.1, X14.1
IN10: R40.1, X15.2
IN11: R42.1, X15.1
unnamed: R30.2, U10.1
unnamed: R16.2, U14.1
unnamed: R32.2, U12.1
unnamed: R34.2, U15.1
unnamed: R25.2, U18.1
unnamed: R40.2, U17.1
unnamed: R27.2, U20.1
unnamed: R42.2, U19.1
unnamed: R8.2, U8.1
unnamed: R28.2, U13.1
unnamed: R38.2, U23.1
unnamed: R36.2, U16.1

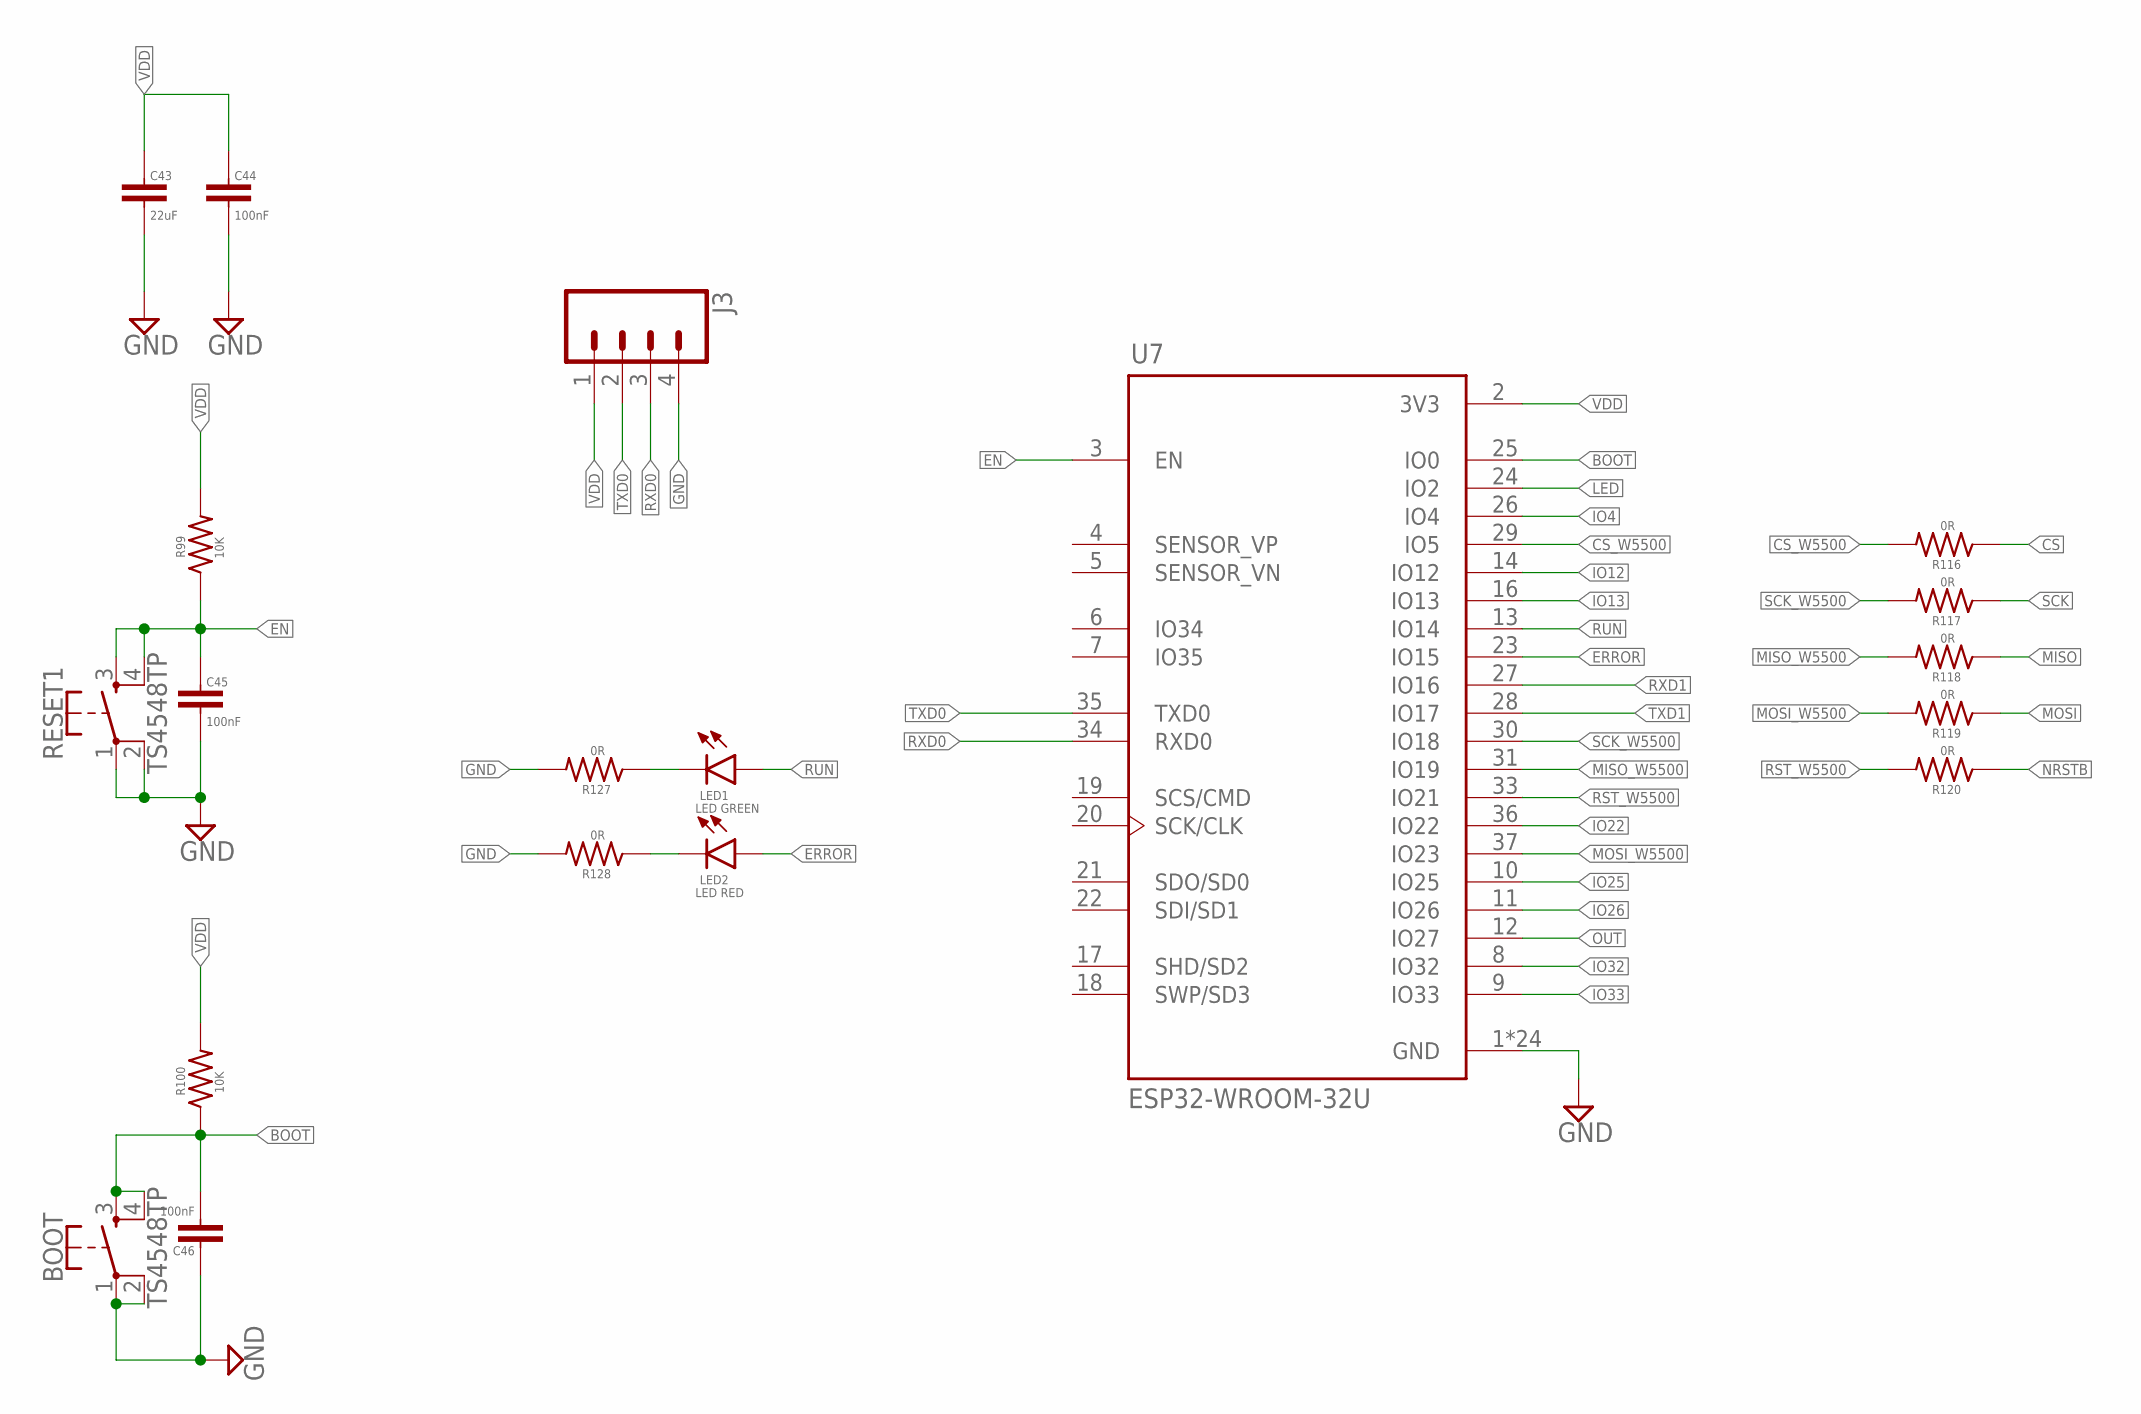
[picture p9: schematic PLC_YN_CPU.sch, sheet 6, WIFI]

Parts:
BOOT: TS4548TP; SWITCH
C43: 22uF; C0603
C44, C45, C46: 100nF; C0603
J3: CONN_04; 1X04
LED1: LED GREEN; L1206
LED2: LED RED; L1206
R99, R100: 10K; R0603
R116, R117, R118, R119, R120, R127, R128: 0R; R0603
RESET1: TS4548TP; SWITCH
U7: ESP32-WROOM-32U; MODULE_ESP32-WROOM-32D

Connections:
BOOT: BOOT.3, BOOT.4, C46.2, R100.1, U7.25 (IO0)
CS: R116.1; also elsewhere on the board
CS_W5500: R116.2, U7.29 (IO5)
EN: C45.1, R99.1, RESET1.3, RESET1.4, U7.3 (EN)
ERROR: LED2.A, U7.23 (IO15)
GND: BOOT.1, BOOT.2, C43.2, C44.2, C45.2, C46.1, J3.4, R127.2, R128.2, RESET1.1, RESET1.2, U7.1 (GND), U7.15 (GND), U7.38 (GND), U7.39_1 (GND), U7.39_2 (GND), U7.39_3 (GND), U7.39_4 (GND), U7.39_5 (GND), U7.39_6 (GND), U7.39_7 (GND), U7.39_8 (GND), U7.39_9 (GND), U7.39_10 (GND), U7.39_11 (GND), U7.39_12 (GND), U7.39_13 (GND), U7.39_14 (GND), U7.39_15 (GND), U7.39_16 (GND), U7.39_17 (GND), U7.39_18 (GND), U7.39_19 (GND), U7.39_20 (GND), U7.39_21 (GND); also elsewhere on the board
IO4: U7.26 (IO4)
IO12: U7.14 (IO12)
IO13: U7.16 (IO13)
IO22: U7.36 (IO22)
IO25: U7.10 (IO25)
IO26: U7.11 (IO26)
IO32: U7.8 (IO32)
IO33: U7.9 (IO33)
LED: U7.24 (IO2)
MISO: R118.1; also elsewhere on the board
MISO_W5500: R118.2, U7.31 (IO19)
MOSI: R119.1; also elsewhere on the board
MOSI_W5500: R119.2, U7.37 (IO23)
unnamed: LED1.C, R127.1
unnamed: LED2.C, R128.1
NRSTB: R120.1; also elsewhere on the board
OUT: U7.12 (IO27)
RST_W5500: R120.2, U7.33 (IO21)
RUN: LED1.A, U7.13 (IO14)
RXD0: J3.3, U7.34 (RXD0); also elsewhere on the board
RXD1: U7.27 (IO16)
SCK: R117.1; also elsewhere on the board
SCK_W5500: R117.2, U7.30 (IO18)
TXD0: J3.2, U7.35 (TXD0); also elsewhere on the board
TXD1: U7.28 (IO17)
VDD: C43.1, C44.1, J3.1, R99.2, R100.2, U7.2 (3V3); also elsewhere on the board

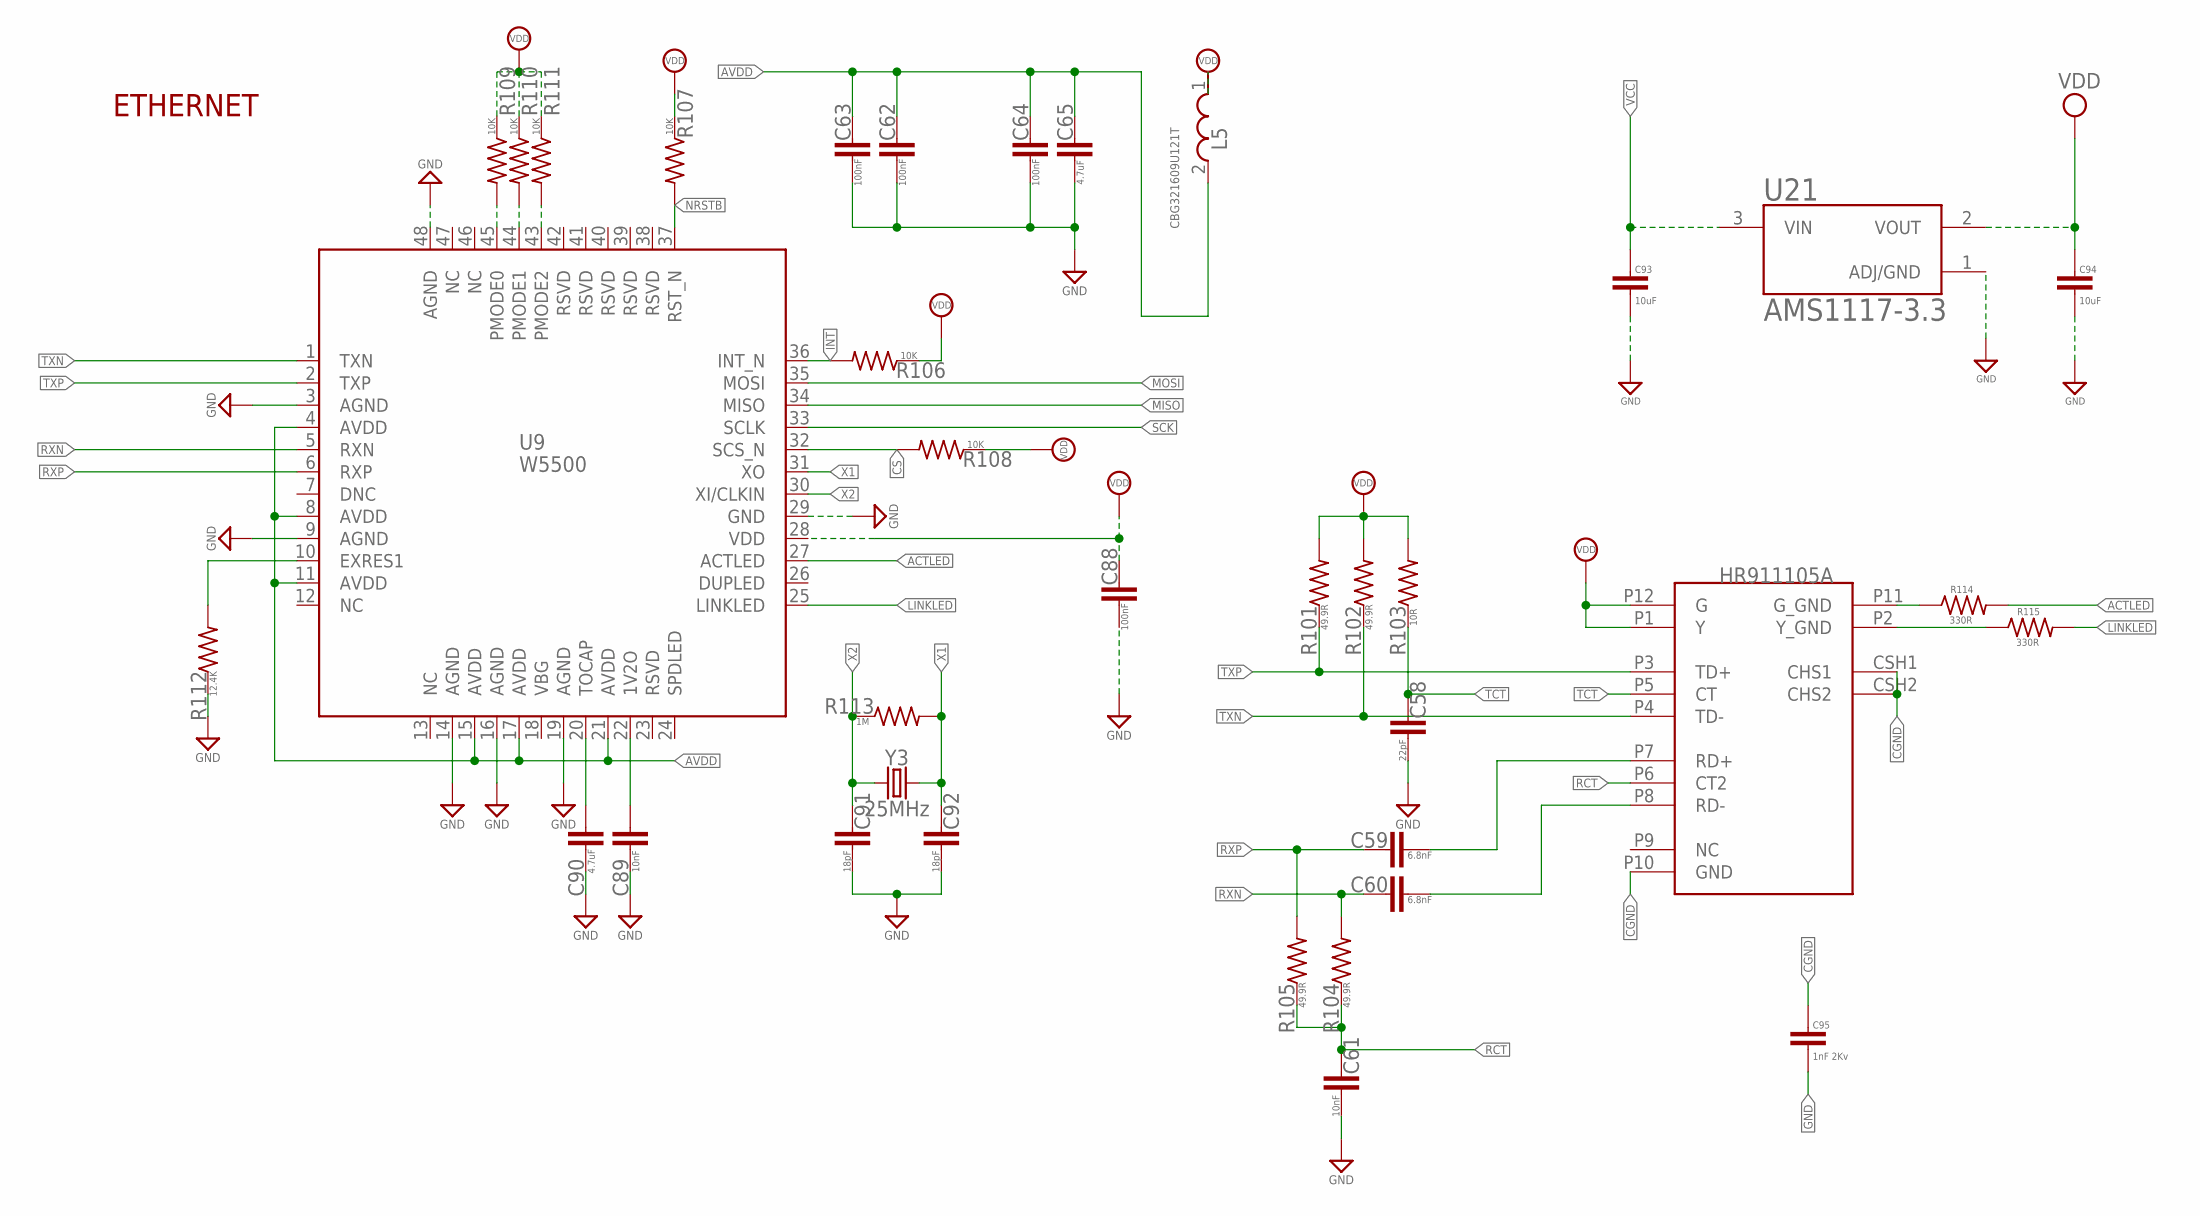
[picture p10: schematic PLC_YN_CPU.sch, sheet 7, ETHERNET]

Parts:
C58: 22pF; C0603
C59, C60: 6.8nF; C0603
C61, C89: 10nF; C0603
C62, C63, C64, C88: 100nF; C0603
C65, C90: 4.7uF; C0603
C91, C92: 18pF; C0603
C93, C94: 10uF; SMD_1206
C95: 1nF 2Kv; SMD_1206
L5: CBG321609U121T; SMD_1206
R101, R102, R104, R105: 49.9R; R0603
R103: 10R; R0603
R106, R107, R108, R109, R110, R111: 10K; R0603
R112: 12.4K; R0603
R113: 1M; R0603
R114, R115: 330R; R0603
U9: W5500
U21: AMS1117-3.3; SOT229P700X180-4N
X4: HR961160C
Y3: 25MHz; HC49UP

Connections:
ACTLED: R114.2, U9.27 (ACTLED)
AVDD: C62.1, C63.1, C64.1, C65.1, L5.2, U9.4 (AVDD), U9.8 (AVDD), U9.11 (AVDD), U9.15 (AVDD), U9.17 (AVDD), U9.21 (AVDD)
CGND: C95.1, X4.CSH1 (CHS1), X4.CSH2 (CHS2), X4.P10 (GND)
CS: R108.2, U9.32 (SCS_N); also elsewhere on the board
GND: C58.2, C61.2, C62.2, C63.2, C64.2, C65.2, C88.2, C89.2, C90.2, C91.2, C92.2, C93.2, C94.2, C95.2, R112.1, U9.3 (AGND), U9.9 (AGND), U9.14 (AGND), U9.16 (AGND), U9.19 (AGND), U9.29 (GND), U9.48 (AGND), U21.1 (ADJ/GND); also elsewhere on the board
INT: R106.2, U9.36 (INT_N)
LINKLED: R115.2, U9.25 (LINKLED)
MISO: U9.34 (MISO); also elsewhere on the board
MOSI: U9.35 (MOSI); also elsewhere on the board
unnamed: C59.2, X4.P7 (RD+)
unnamed: C60.2, X4.P8 (RD-)
unnamed: R111.2, U9.43 (PMODE2)
unnamed: C89.1, U9.22 (1V2O)
unnamed: C90.1, U9.20 (TOCAP)
unnamed: R112.2, U9.10 (EXRES1)
unnamed: R109.2, U9.45 (PMODE0)
unnamed: R110.2, U9.44 (PMODE1)
unnamed: R114.1, X4.P11 (G_GND)
unnamed: R115.1, X4.P2 (Y_GND)
NRSTB: R107.2, U9.37 (RST_N); also elsewhere on the board
RCT: C61.1, R104.1, R105.1, X4.P6 (CT2)
RXN: C60.1, R104.2, U9.5 (RXN)
RXP: C59.1, R105.2, U9.6 (RXP)
SCK: U9.33 (SCLK); also elsewhere on the board
TCT: C58.1, R103.1, X4.P5 (CT)
TXN: R102.1, U9.1 (TXN), X4.P4 (TD-)
TXP: R101.1, U9.2 (TXP), X4.P3 (TD+)
VCC: C93.1, U21.3 (VIN); also elsewhere on the board
VDD: C88.1, C94.1, L5.1, R101.2, R102.2, R103.2, R106.1, R107.1, R108.1, R109.1, R110.1, R111.1, U9.28 (VDD), U21.2 (VOUT), X4.P1 (Y), X4.P12 (G); also elsewhere on the board
X1: C92.1, R113.2, U9.31 (XO), Y3.2
X2: C91.1, R113.1, U9.30 (XI/CLKIN), Y3.1

Notes on the sheet:
ETHERNET

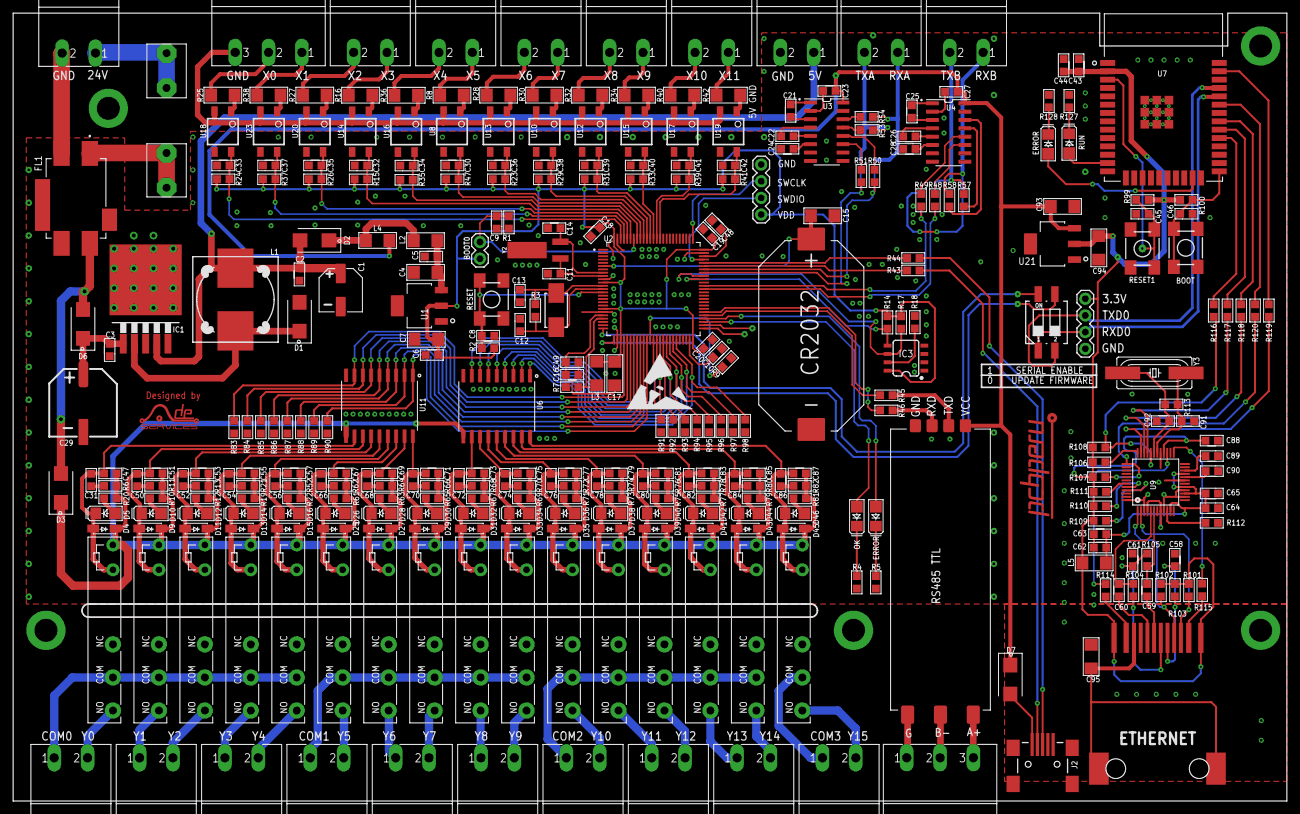
[picture p11: board PLC_YN_CPU.brd from above]

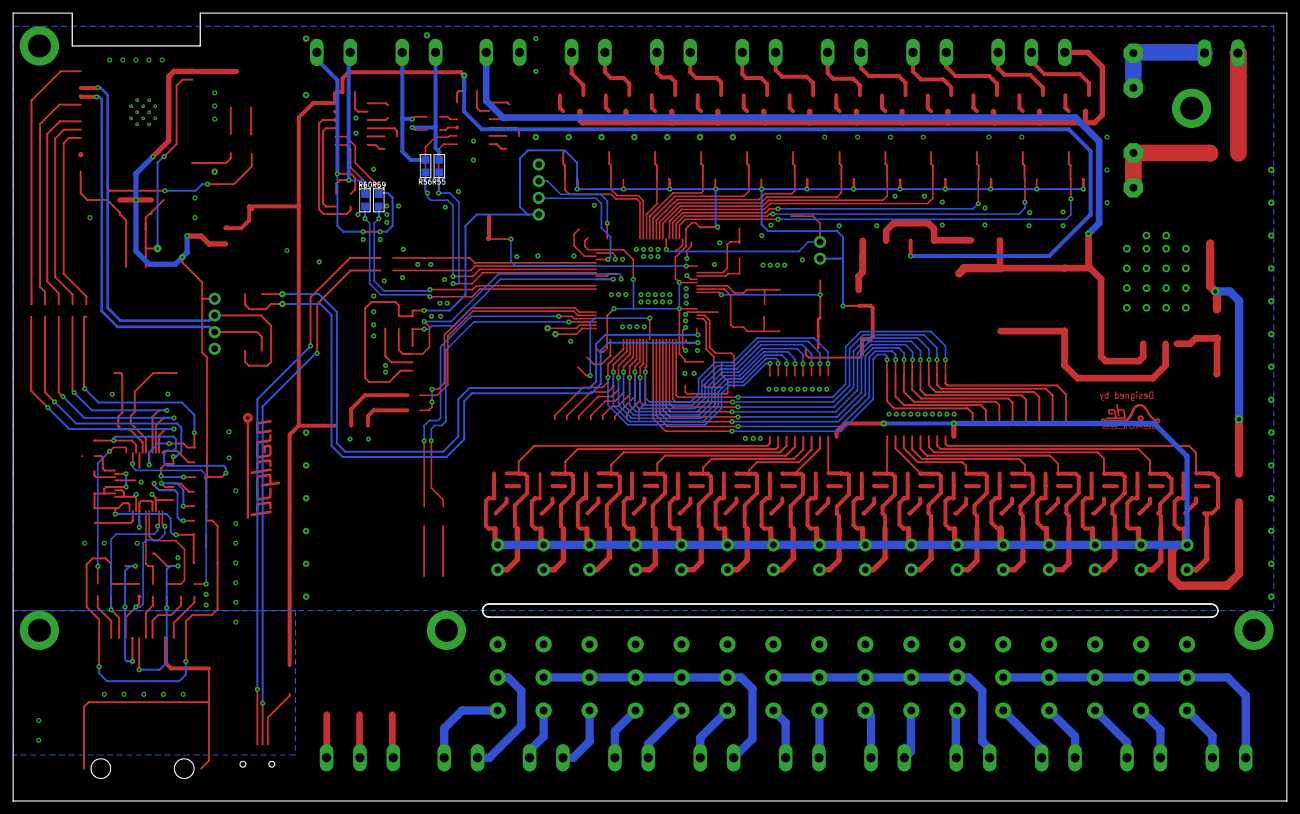
[picture p12: board PLC_YN_CPU.brd from below]

Board: 2 copper layers, 194.0 x 120.0 mm, 342 parts (4 on the bottom side), 239 nets.

Other parts of the board:
ES: ESD_10.00
U$2: PCB_PERU
U$3: ADE2021
